DaviVolcan/STM32H743IIT6-Core-Board/README.md

# STM32H743IIT6 Core Board V1.3

Community documentation for the STM32H743IIT6 Core Board V1.3, produced by a Chinese manufacturer.

> **Note:** The original manufacturer schematics are not included in this repository because it has not been possible
> to get in contact with the manufacturer. A community re-capture of the V1.3 schematic in KiCad is available in
> [hardware/kicad](hardware/kicad/STM32H743_CoreBoard), with a
> [PDF render](hardware/kicad/STM32H743_CoreBoard/STM32H743_CoreBoard_render.pdf).
> **Note:** We are not fully sure about the exact manufacturer company name yet.

---

## Overview

| Item | Details |
|---|---|
| MCU | STM32H743IIT6 (LQFP176) |
| Core | ARM Cortex-M7 @ up to 480 MHz |
| Flash | 2 MB internal + 16 MB external QSPI |
| RAM | 1 MB internal + 32MB external SDRAM |
| Board revision | V1.3 |
| Schematic date | Unknown |

---

## Board Pictures

### Top View
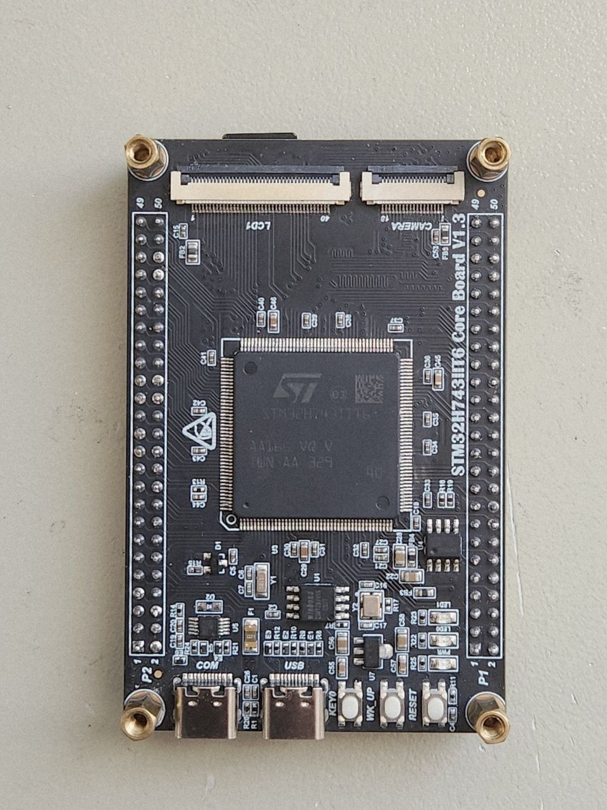
[picture p1: assets/top.jpg]
STM32H743IIT6 Core Board - Top View


> **Note:** One diode is missing on this top-side photo.

### Bottom View
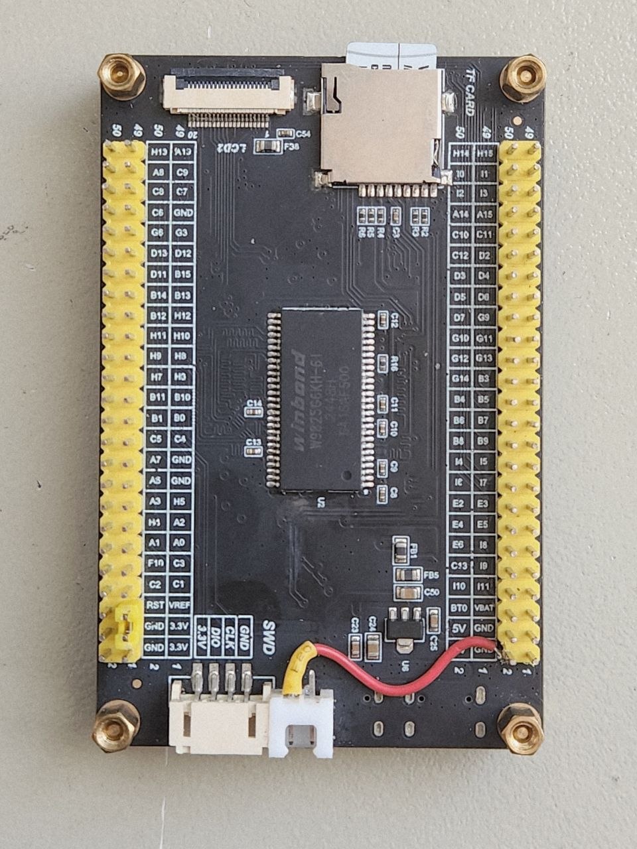
[picture p2: assets/bottom.jpg]
STM32H743IIT6 Core Board - Bottom View


> **Note:** This bottom-side photo shows a user-applied mod.

### Component Close-ups

Close-up photos used to identify the on-board parts are shown in
[Peripheral Details](docs/peripherals.md):

- [QSPI flash, HSE crystal, LDO and EEPROM](assets/closeup-qspi-hse-ldo.jpg) — see
  [Clocks](docs/peripherals.md#clocks), [QSPI Flash](docs/peripherals.md#qspi-flash) and
  [Power](docs/peripherals.md#power)
- [SDRAM and header silkscreen](assets/closeup-sdram-headers.jpg) — see
  [SDRAM](docs/peripherals.md#sdram)
- [EEPROM (U4)](assets/eeprom.jpg) — see [EEPROM](docs/peripherals.md#eeprom)
- [USB-UART bridge, LSE crystal and USB area](assets/closeup-usb-uart-lse.jpg) — see
  [COM Ports](docs/peripherals.md#com-ports) and [USB](docs/peripherals.md#usb)

---

## Quick Links

- [Pin Assignments](docs/pinout.md)
- [Peripheral Details](docs/peripherals.md)
- [KiCad Schematic](hardware/kicad/STM32H743_CoreBoard) ([PDF](hardware/kicad/STM32H743_CoreBoard/STM32H743_CoreBoard_render.pdf))

---

## Contributing

If you have additional details about this board (measured pin functions, tested peripheral configs, confirmed part
numbers), please open an issue or PR.
