DaviVolcan/STM32H743IIT6-Core-Board/hardware/kicad/STM32H743_CoreBoard/STM32H743_CoreBoard_render.pdf

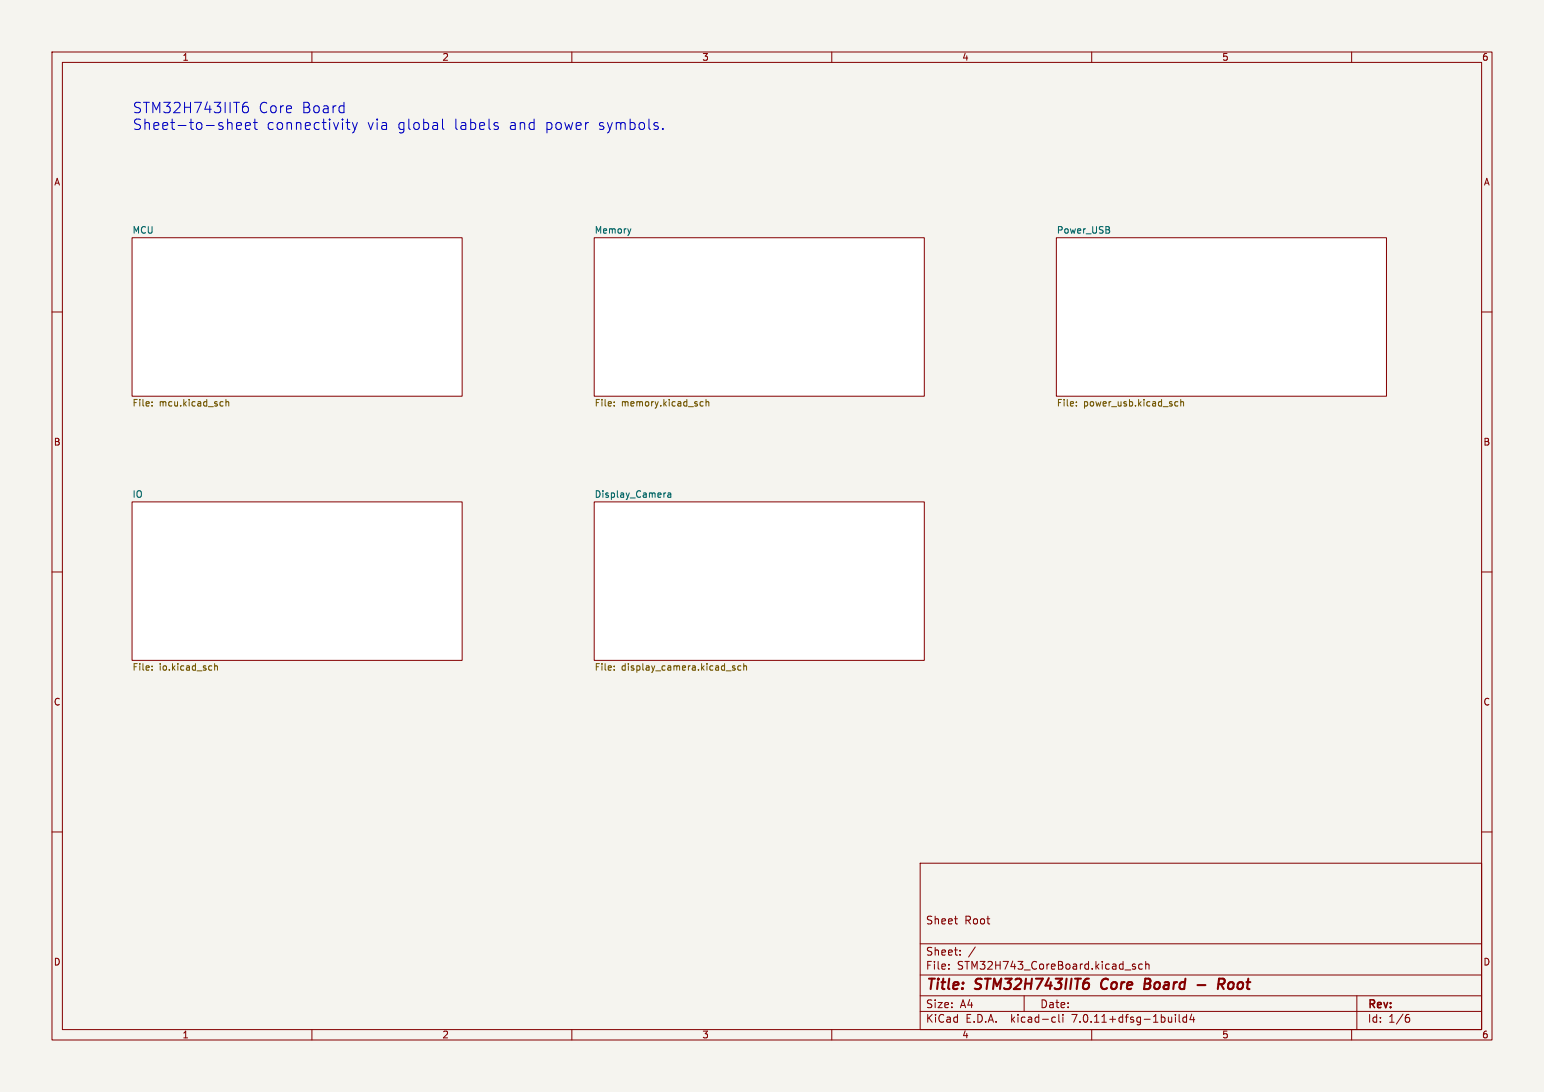
[picture p7: page 1]

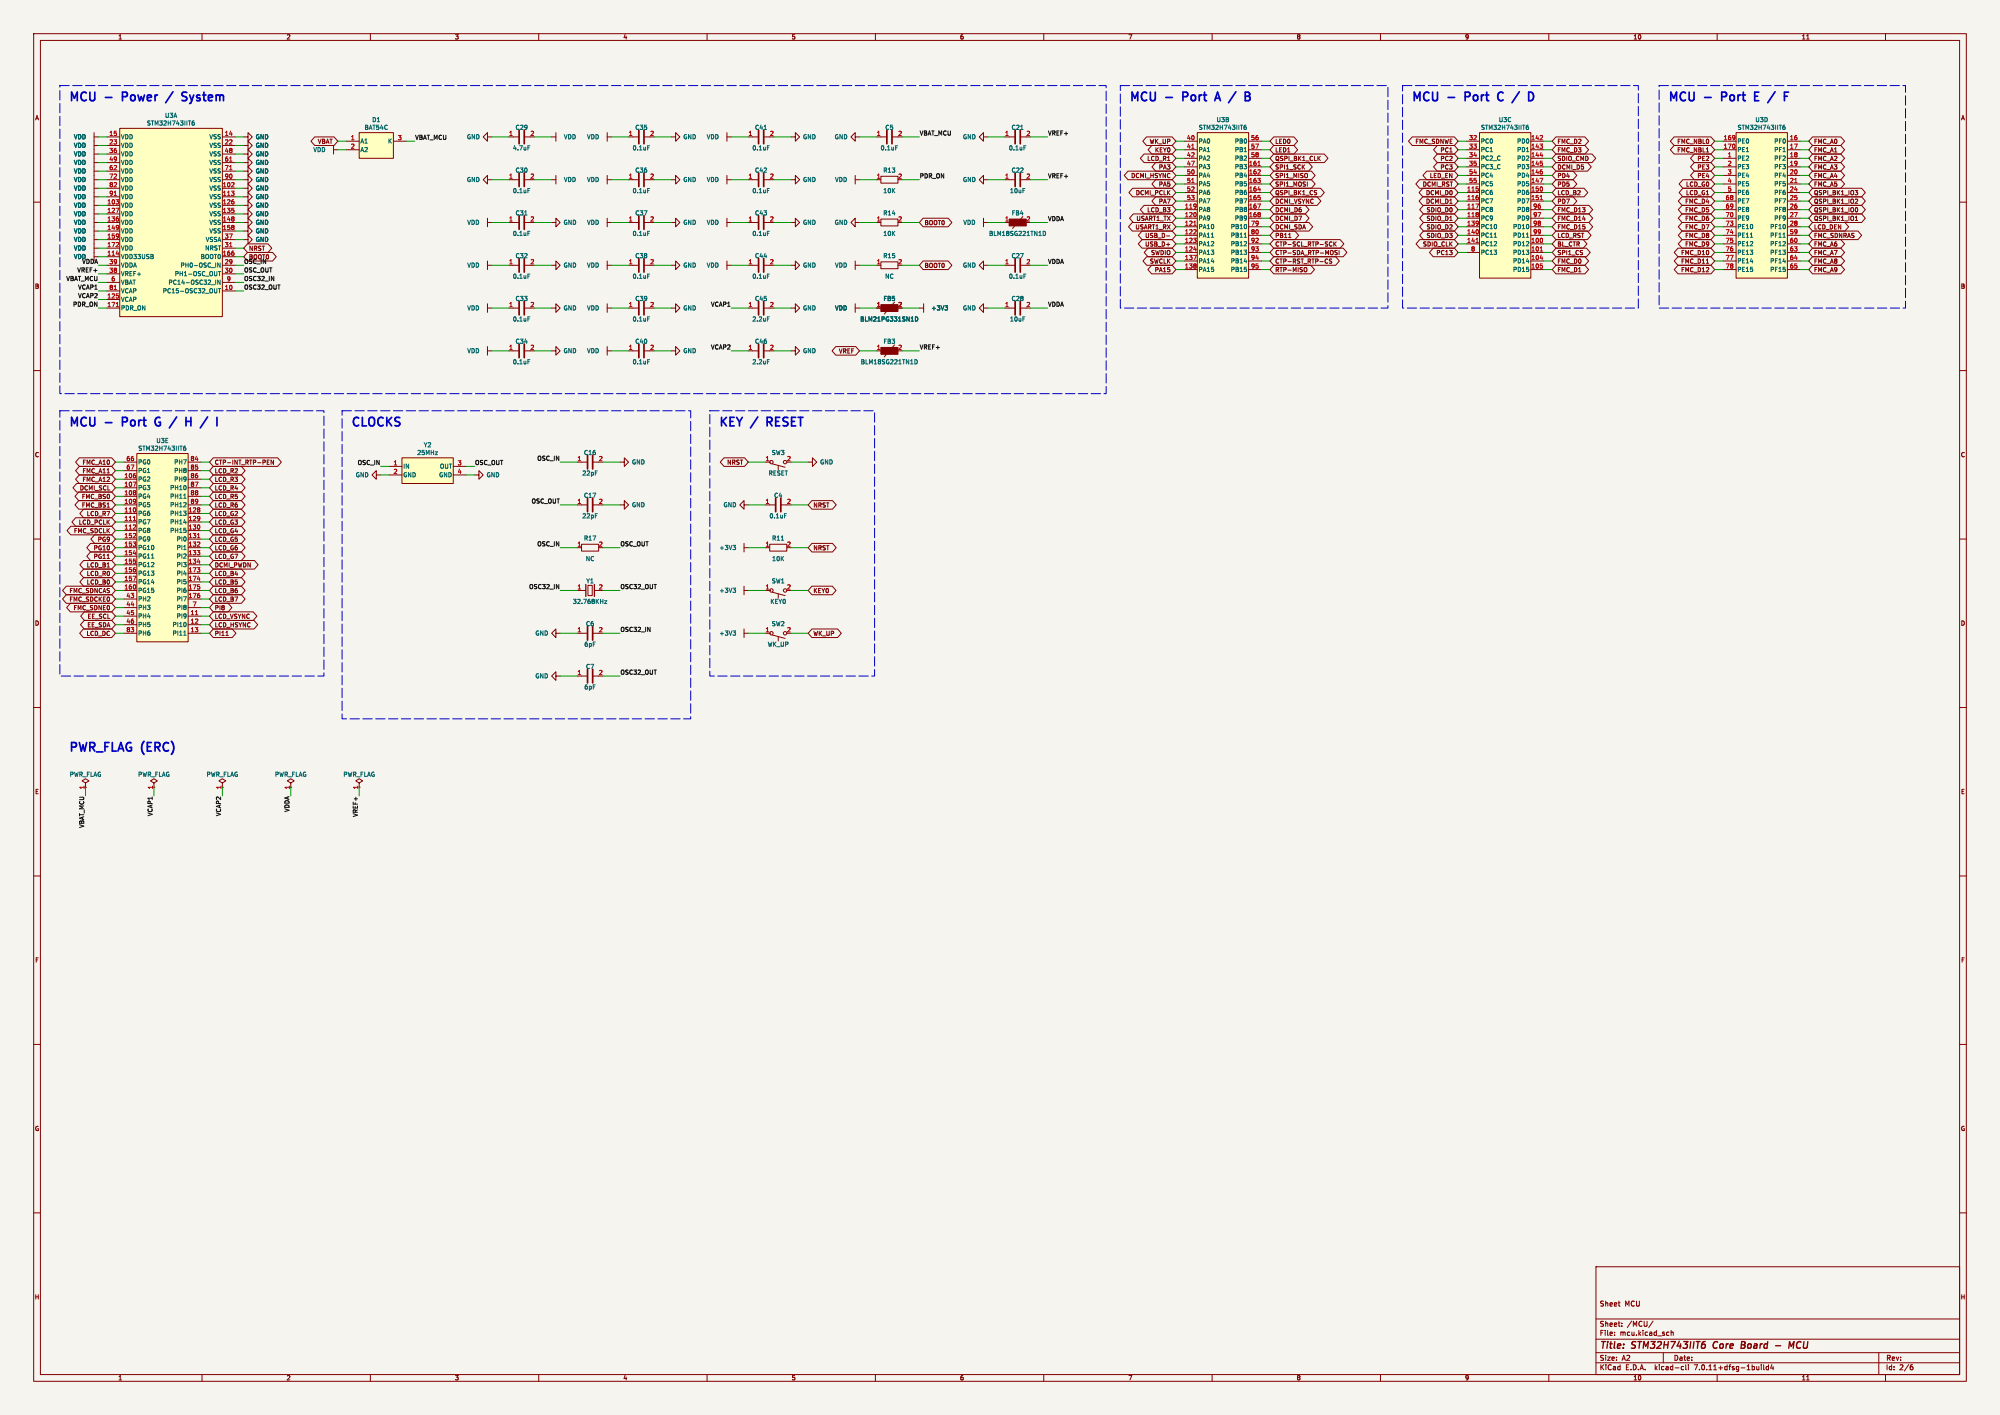
[picture p8: page 2]

PB11 CTP-SCL_RTP-SCK CTP-SDA_RTP-MOSI CTP-RST_RTP-CS RTP-MISO

File: mcu.kicad_sch Sheet: /MCU/ Sheet MCU

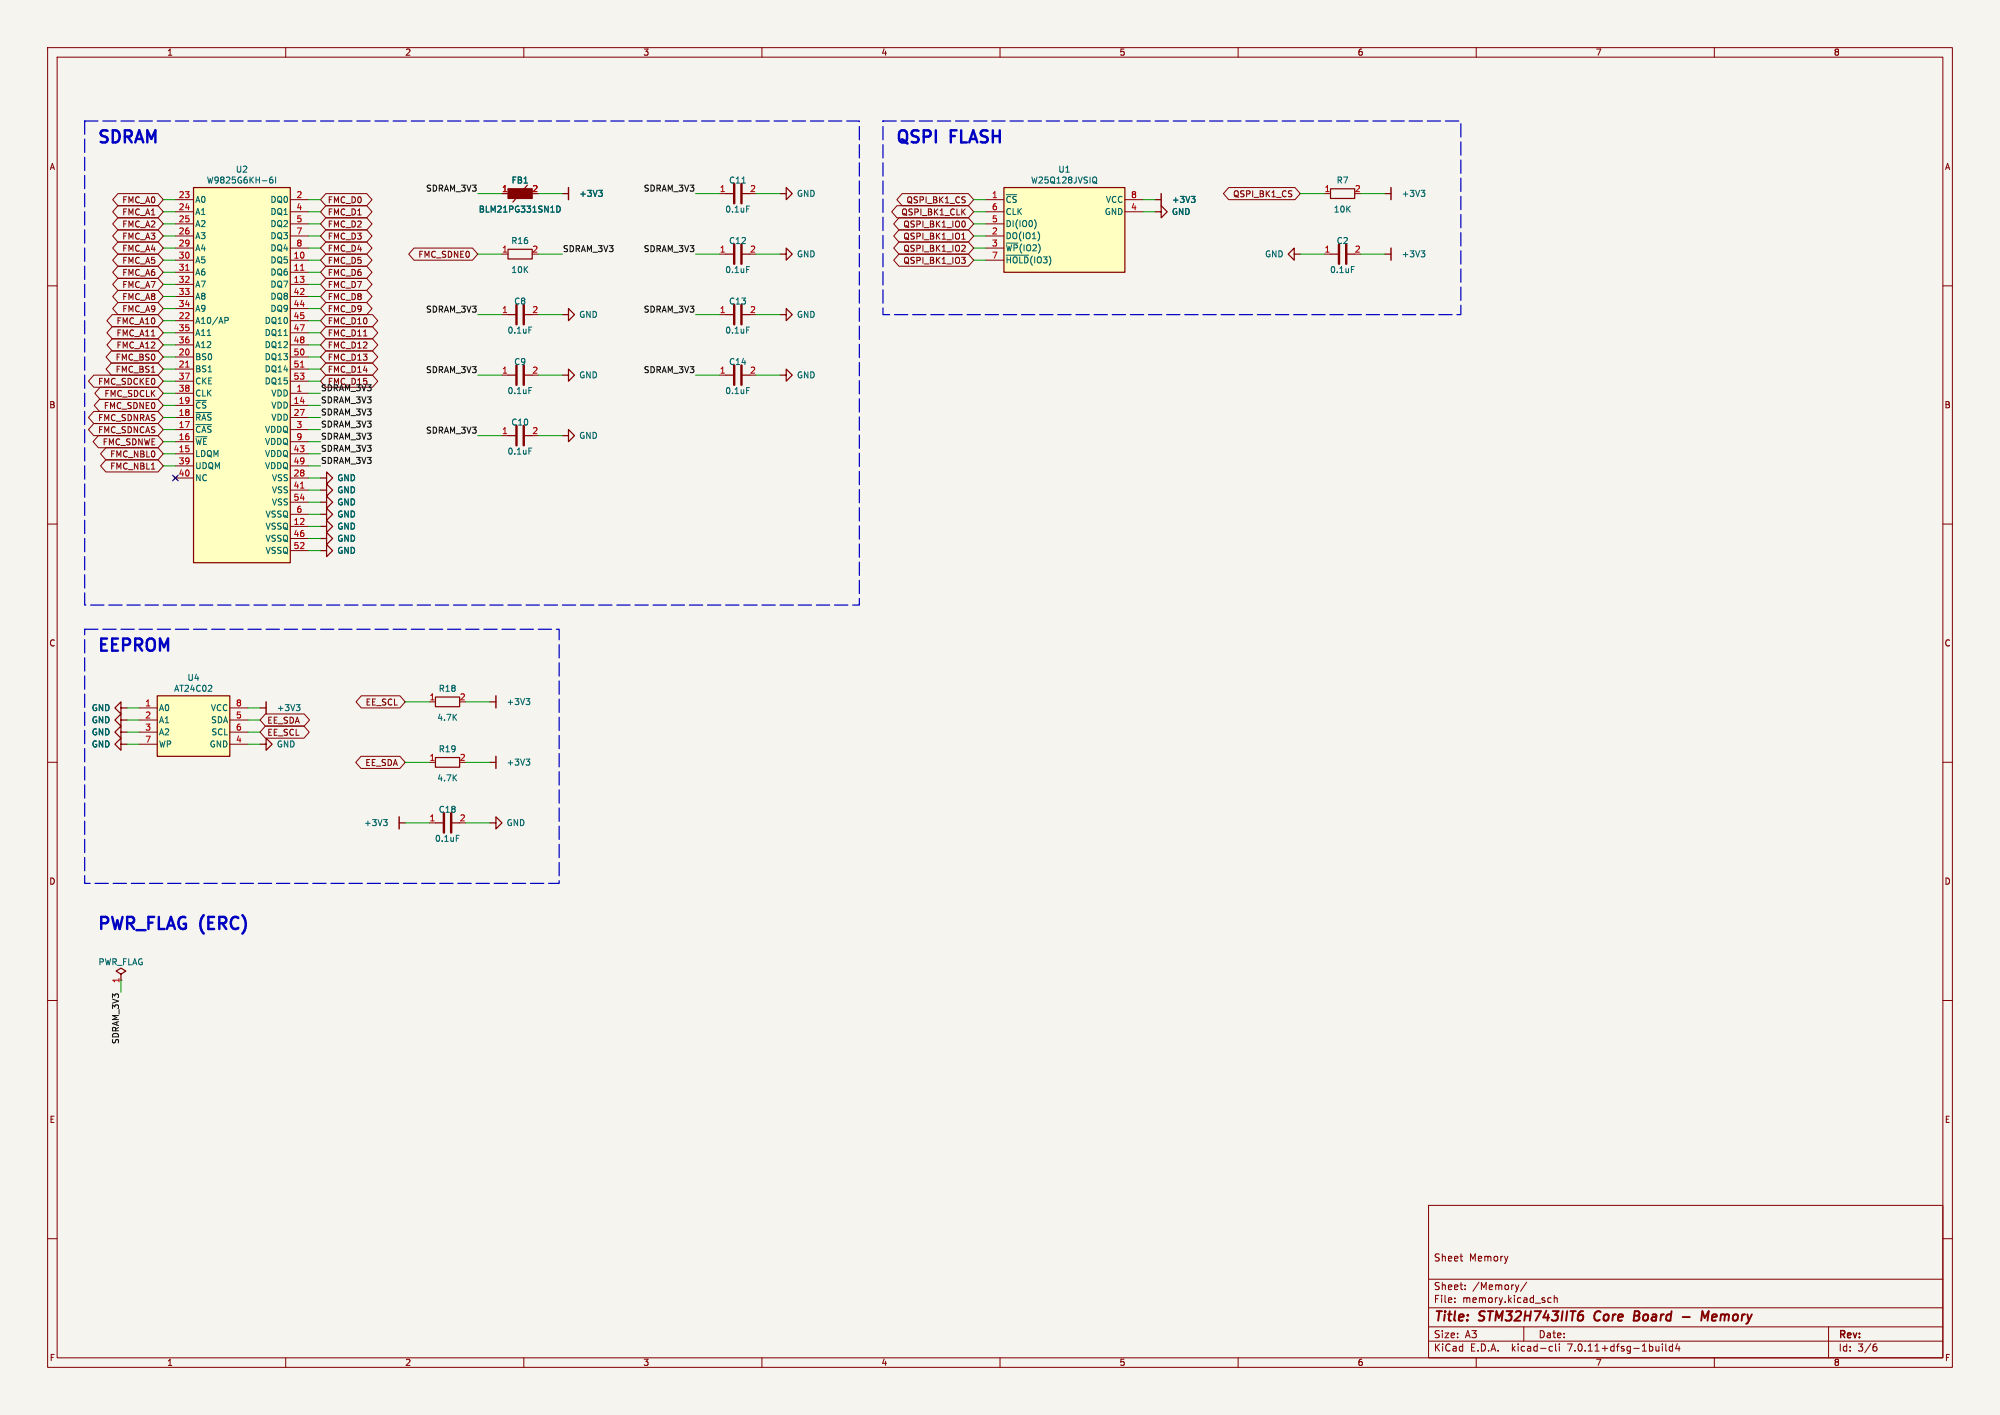
[picture p9: page 3]

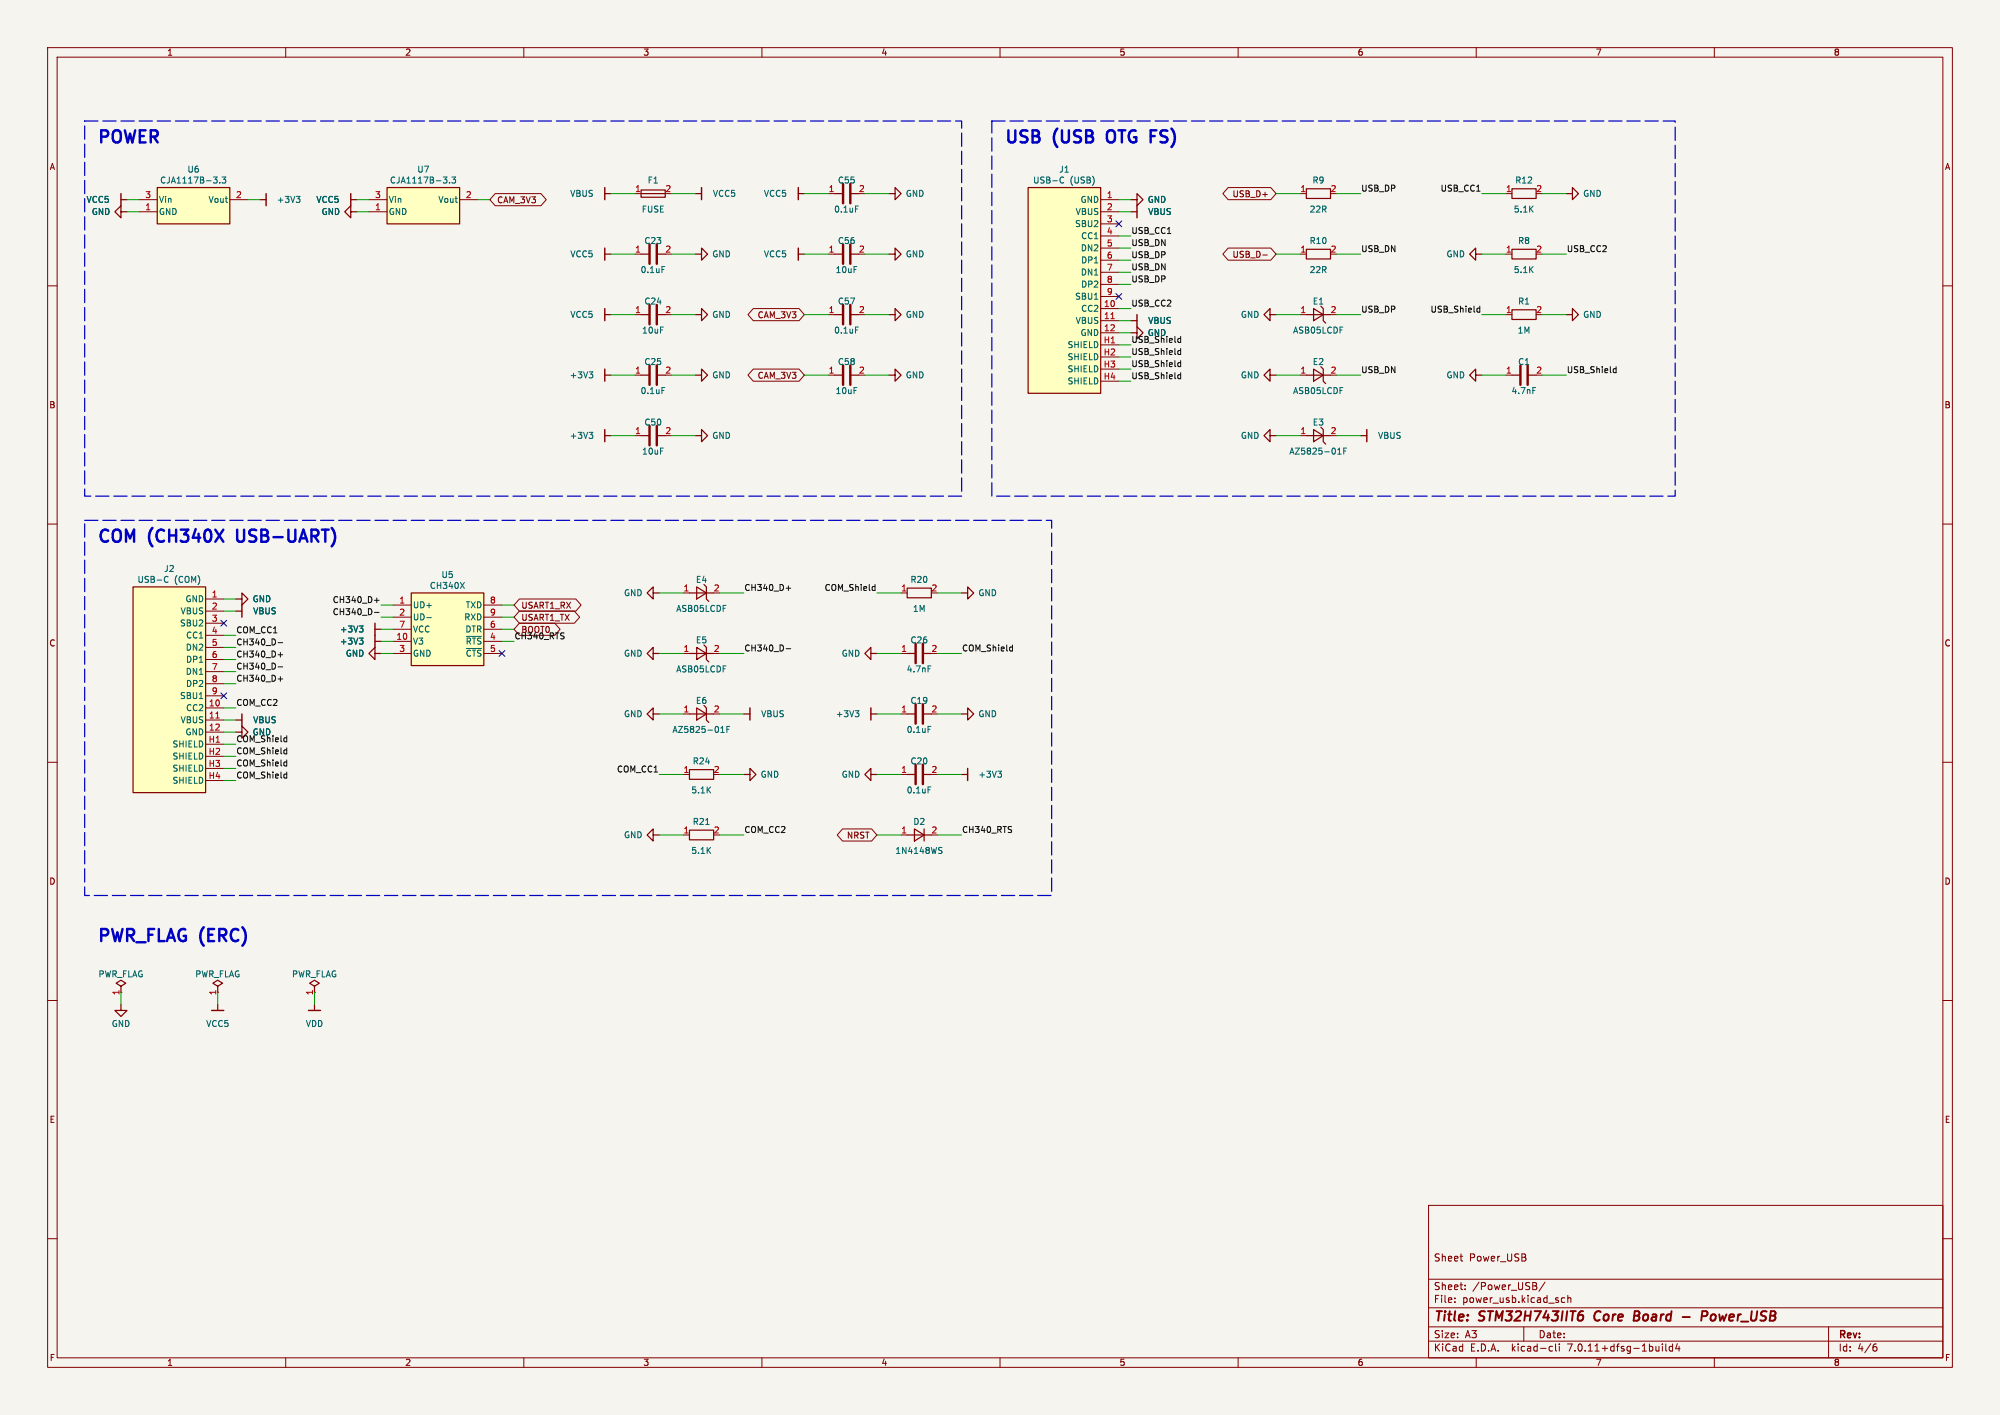
[picture p10: page 4]

COM (CH340X USB-UART) VBUS GND

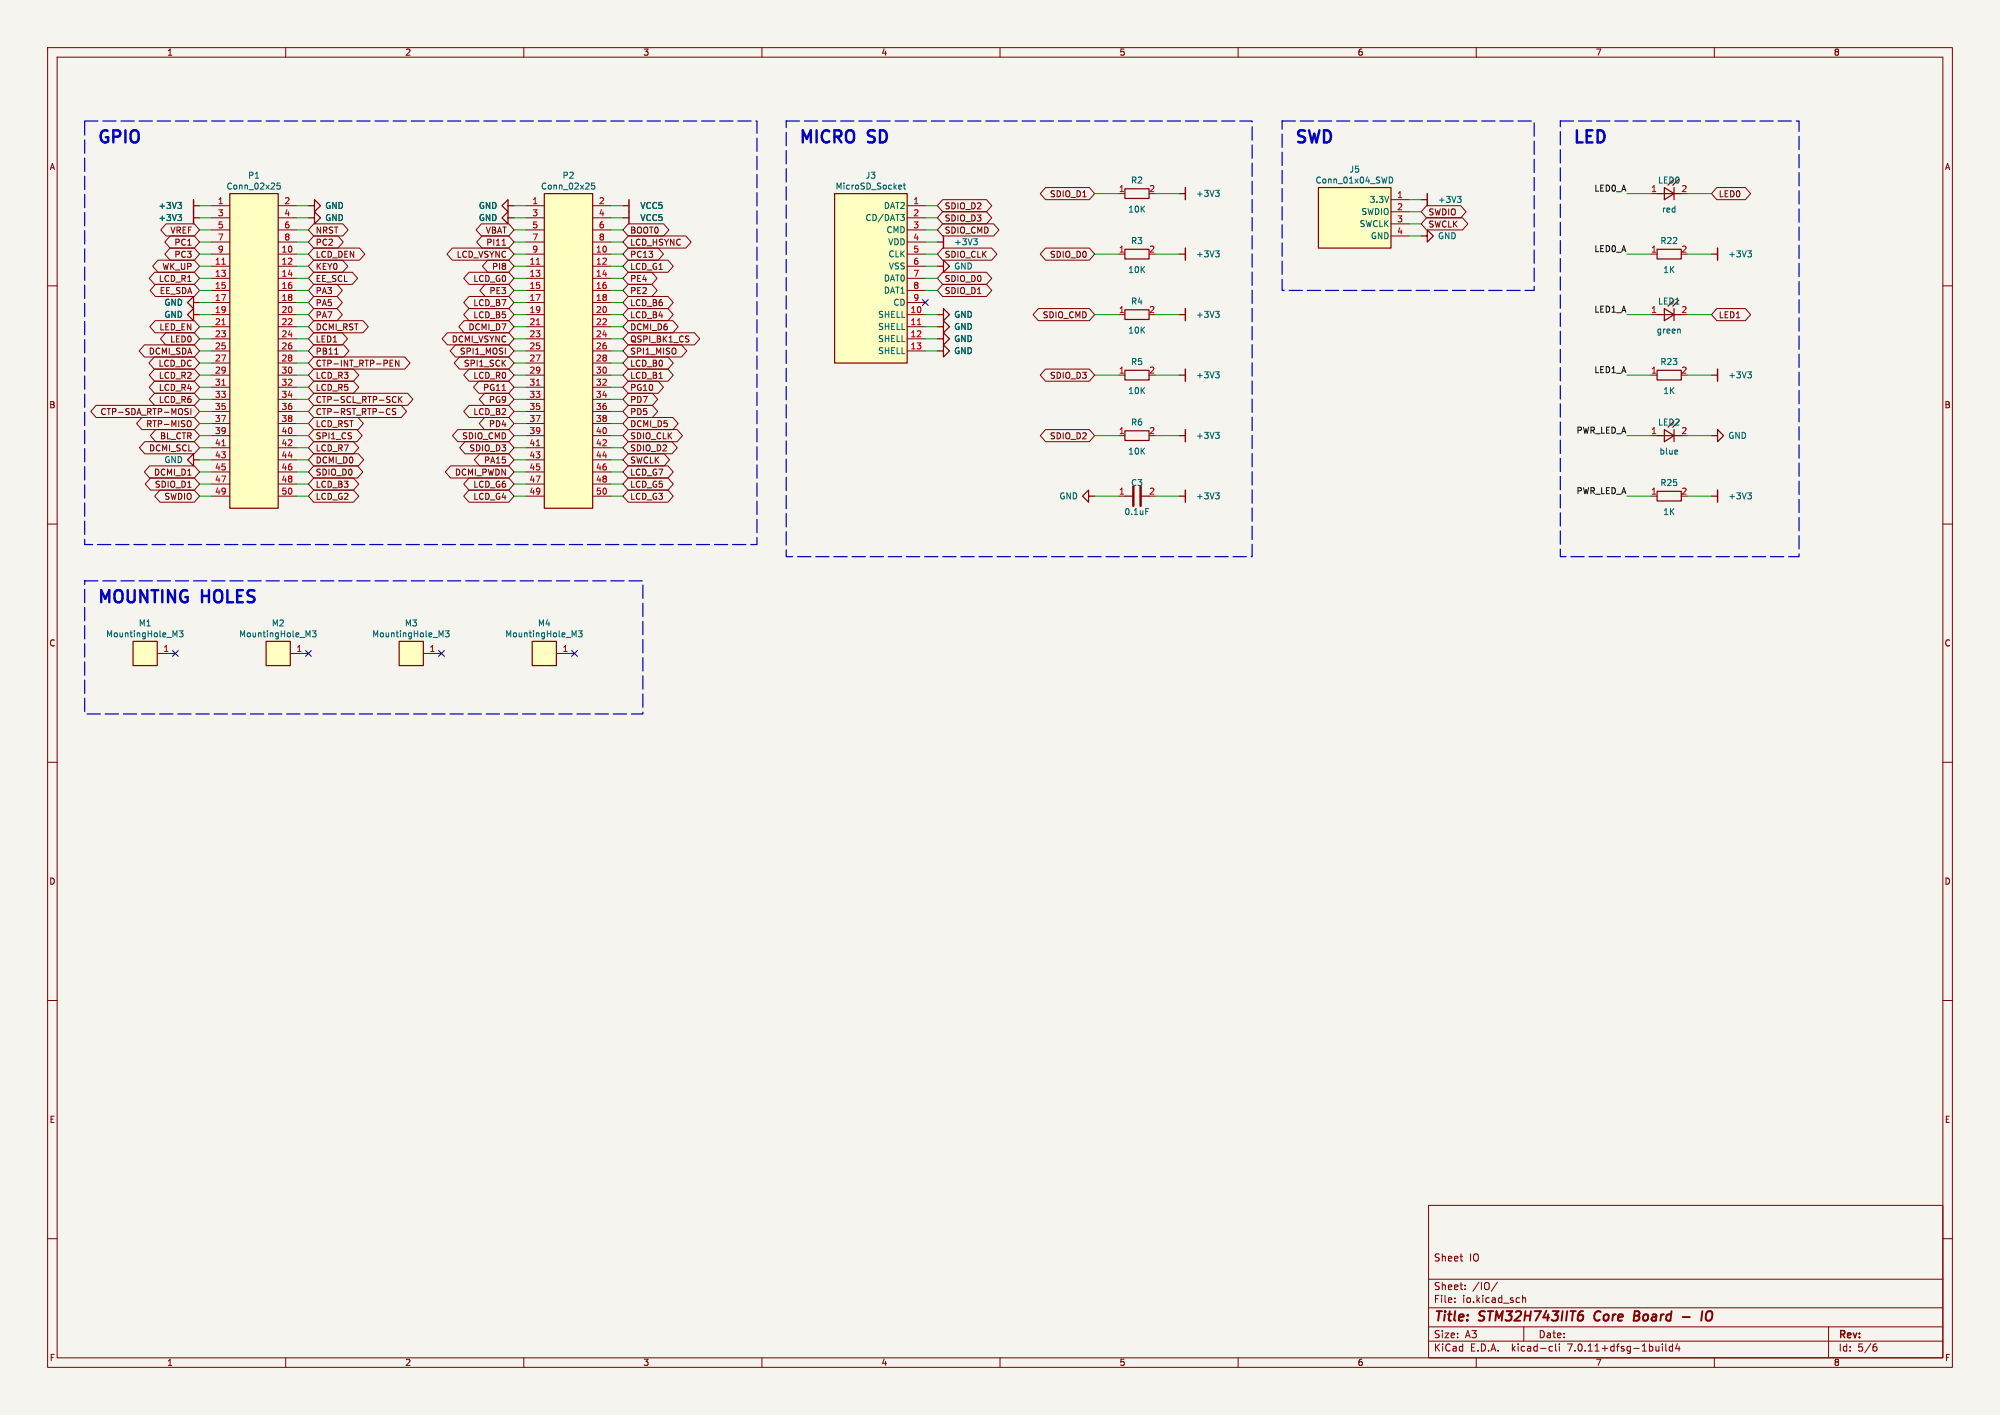
[picture p11: page 5]

green GND GND GND GND

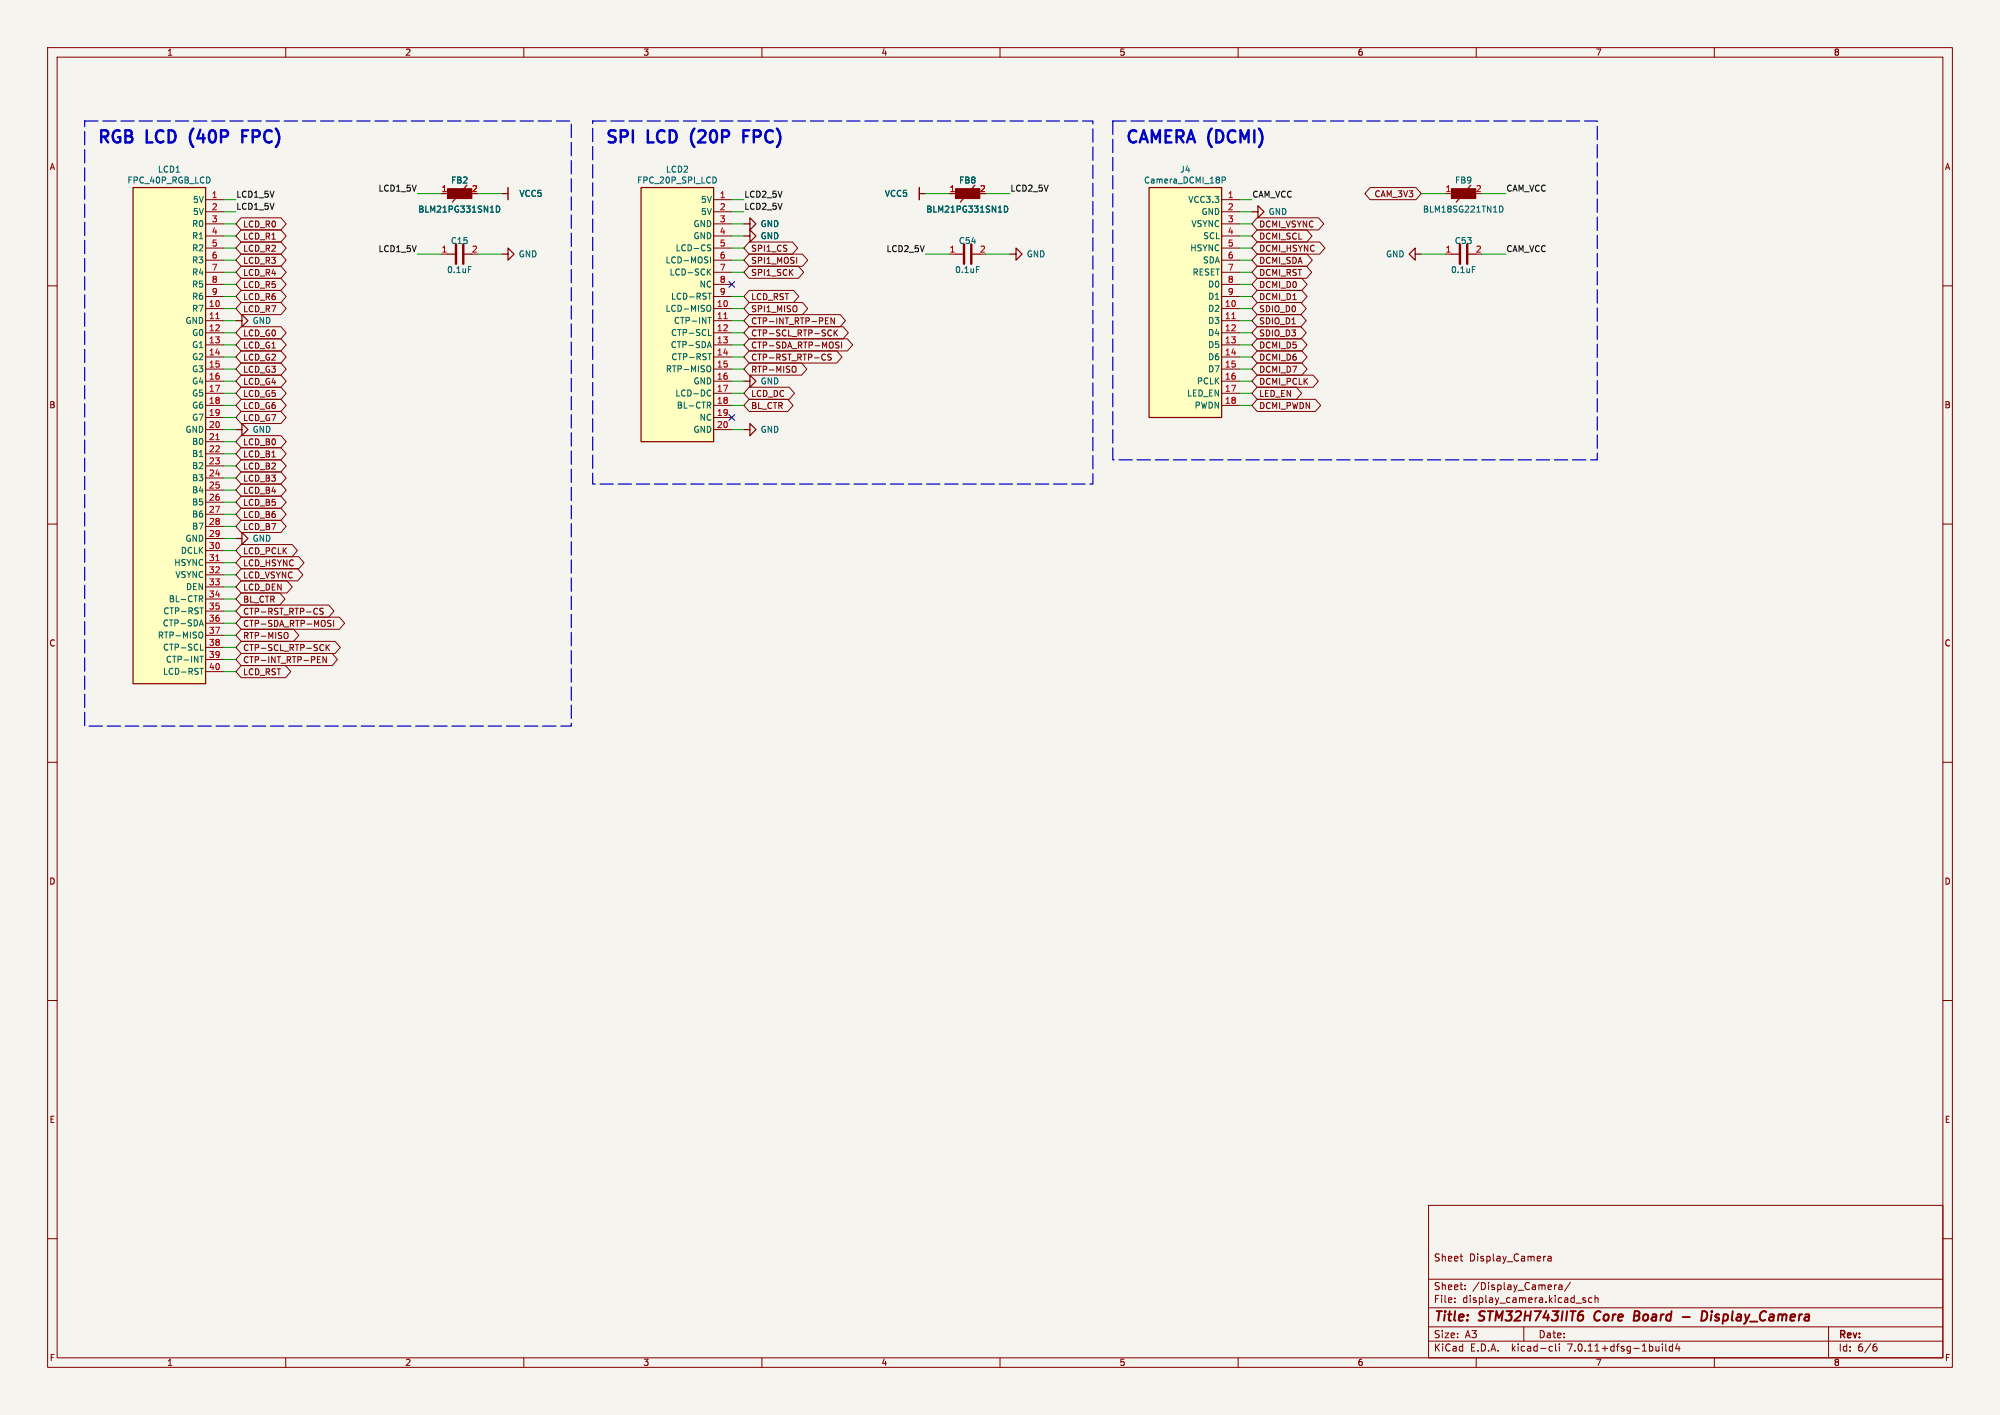
[picture p12: page 6]

LED_EN 17 PWDN 18 GND 2 VSYNC 3 SCL 4 HSYNC 5 SDA 6 RESET 7 D0 8 D1 9

CTP-INT_RTP-PEN
CTP-SCL_RTP-SCK CTP-SDA_RTP-MOSI CTP-RST_RTP-CS RTP-MISO
