DaviVolcan/STM32H743IIT6-Core-Board/hardware/kicad/STM32H743_CoreBoard/display_camera.kicad_sch

## KiCad design hardware/kicad/STM32H743_CoreBoard/display_camera.kicad_sch (2026-11-04)

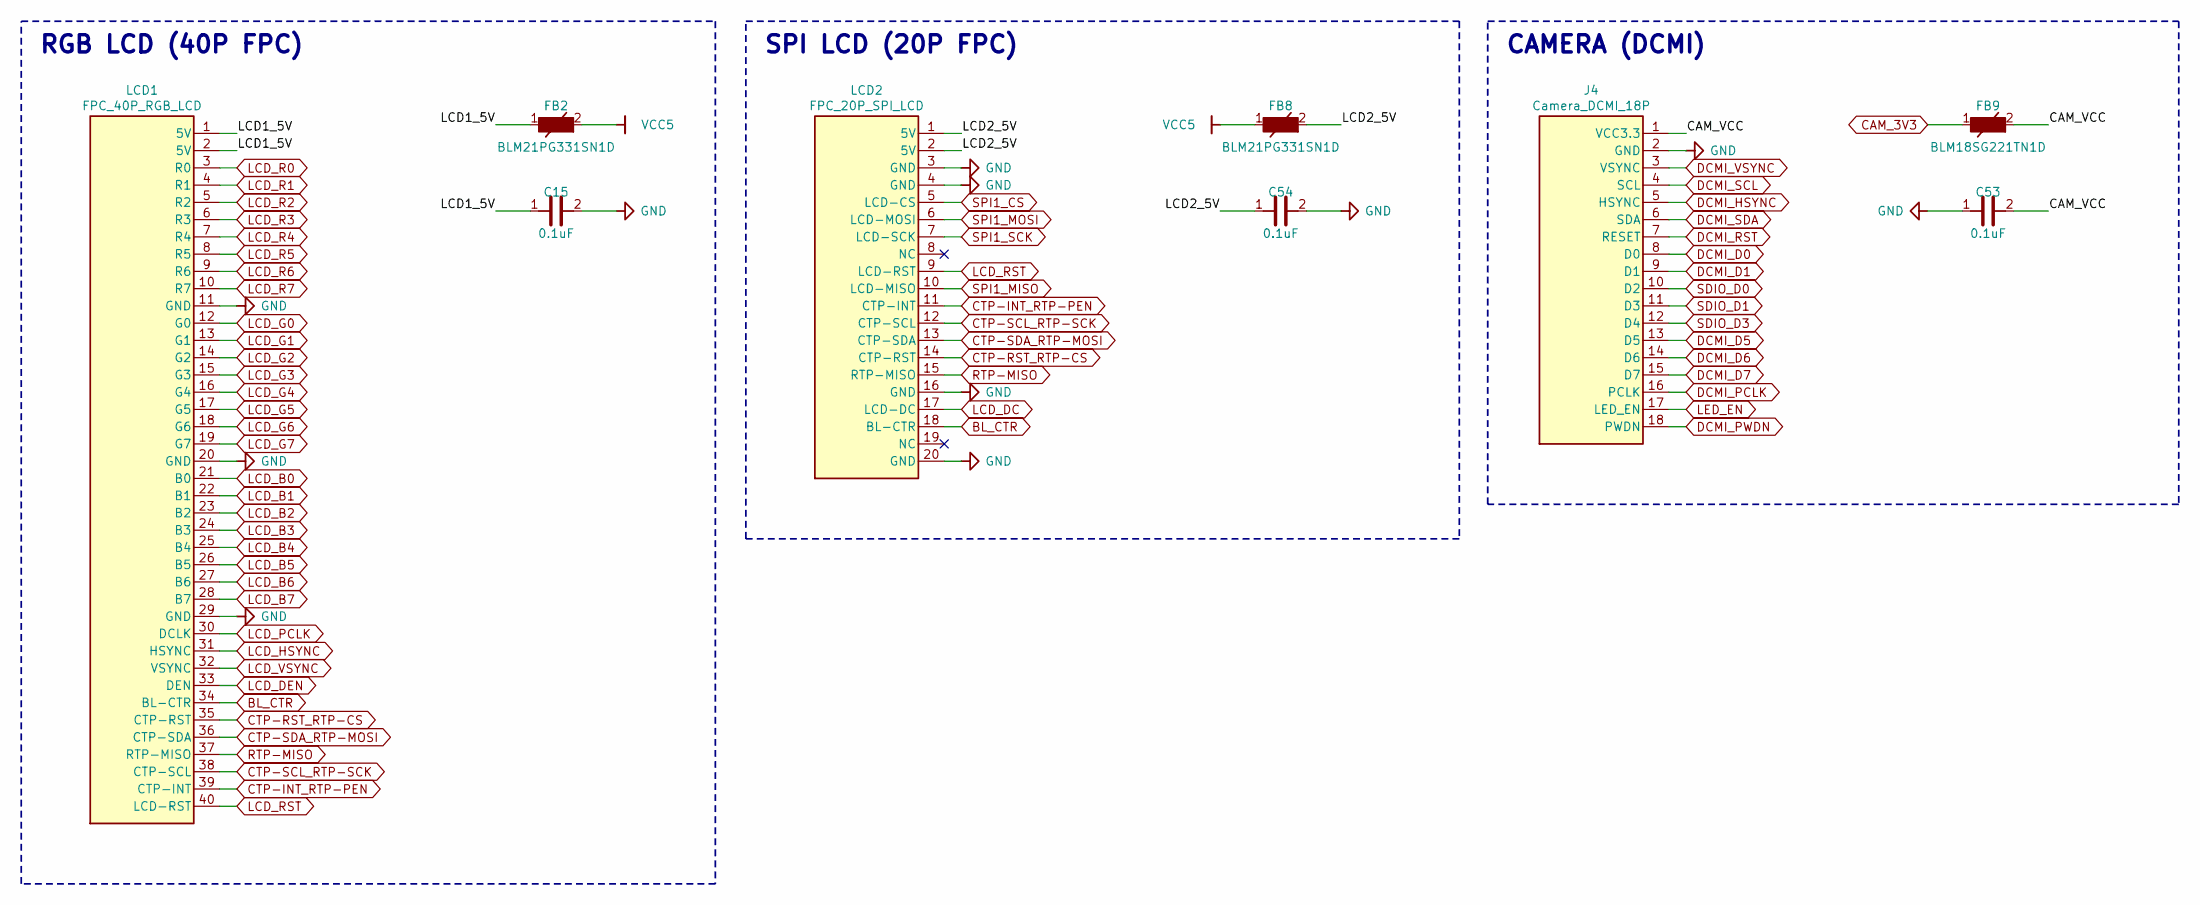
[picture p13: schematic display_camera.kicad_sch]

Parts:
C15, C53, C54: 0.1uF; C_0603_1608Metric
FB2, FB8: BLM21PG331SN1D; L_0805_2012Metric
FB9: BLM18SG221TN1D; L_0603_1608Metric
J4: Camera_DCMI_18P
LCD1: FPC_40P_RGB_LCD
LCD2: FPC_20P_SPI_LCD

Connections:
BL_CTR: LCD1.34 (BL-CTR), LCD2.18 (BL-CTR)
CAM_3V3: FB9.1
CAM_VCC: C53.2, FB9.2, J4.1 (VCC3.3)
CTP-INT_RTP-PEN: LCD1.39 (CTP-INT), LCD2.11 (CTP-INT)
CTP-RST_RTP-CS: LCD1.35 (CTP-RST), LCD2.14 (CTP-RST)
CTP-SCL_RTP-SCK: LCD1.38 (CTP-SCL), LCD2.12 (CTP-SCL)
CTP-SDA_RTP-MOSI: LCD1.36 (CTP-SDA), LCD2.13 (CTP-SDA)
DCMI_D0: J4.8 (D0)
DCMI_D1: J4.9 (D1)
DCMI_D5: J4.13 (D5)
DCMI_D6: J4.14 (D6)
DCMI_D7: J4.15 (D7)
DCMI_HSYNC: J4.5 (HSYNC)
DCMI_PCLK: J4.16 (PCLK)
DCMI_PWDN: J4.18 (PWDN)
DCMI_RST: J4.7 (RESET)
DCMI_SCL: J4.4 (SCL)
DCMI_SDA: J4.6 (SDA)
DCMI_VSYNC: J4.3 (VSYNC)
GND: C15.2, C53.1, C54.2, J4.2 (GND), LCD1.11 (GND), LCD1.20 (GND), LCD1.29 (GND), LCD2.3 (GND), LCD2.4 (GND), LCD2.16 (GND), LCD2.20 (GND)
LCD1_5V: C15.1, FB2.1, LCD1.1 (5V), LCD1.2 (5V)
LCD2_5V: C54.1, FB8.2, LCD2.1 (5V), LCD2.2 (5V)
LCD_B0: LCD1.21 (B0)
LCD_B1: LCD1.22 (B1)
LCD_B2: LCD1.23 (B2)
LCD_B3: LCD1.24 (B3)
LCD_B4: LCD1.25 (B4)
LCD_B5: LCD1.26 (B5)
LCD_B6: LCD1.27 (B6)
LCD_B7: LCD1.28 (B7)
LCD_DC: LCD2.17 (LCD-DC)
LCD_DEN: LCD1.33 (DEN)
LCD_G0: LCD1.12 (G0)
LCD_G1: LCD1.13 (G1)
LCD_G2: LCD1.14 (G2)
LCD_G3: LCD1.15 (G3)
LCD_G4: LCD1.16 (G4)
LCD_G5: LCD1.17 (G5)
LCD_G6: LCD1.18 (G6)
LCD_G7: LCD1.19 (G7)
LCD_HSYNC: LCD1.31 (HSYNC)
LCD_PCLK: LCD1.30 (DCLK)
LCD_R0: LCD1.3 (R0)
LCD_R1: LCD1.4 (R1)
LCD_R2: LCD1.5 (R2)
LCD_R3: LCD1.6 (R3)
LCD_R4: LCD1.7 (R4)
LCD_R5: LCD1.8 (R5)
LCD_R6: LCD1.9 (R6)
LCD_R7: LCD1.10 (R7)
LCD_RST: LCD1.40 (LCD-RST), LCD2.9 (LCD-RST)
LCD_VSYNC: LCD1.32 (VSYNC)
LED_EN: J4.17 (LED_EN)
RTP-MISO: LCD1.37 (RTP-MISO), LCD2.15 (RTP-MISO)
SDIO_D0: J4.10 (D2)
SDIO_D1: J4.11 (D3)
SDIO_D3: J4.12 (D4)
SPI1_CS: LCD2.5 (LCD-CS)
SPI1_MISO: LCD2.10 (LCD-MISO)
SPI1_MOSI: LCD2.6 (LCD-MOSI)
SPI1_SCK: LCD2.7 (LCD-SCK)
VCC5: FB2.2, FB8.1

Notes on the sheet:
RGB LCD (40P FPC)
SPI LCD (20P FPC)
CAMERA (DCMI)
