DaviVolcan/STM32H743IIT6-Core-Board/hardware/kicad/STM32H743_CoreBoard/io.kicad_sch

## KiCad design hardware/kicad/STM32H743_CoreBoard/io.kicad_sch (2026-11-04)

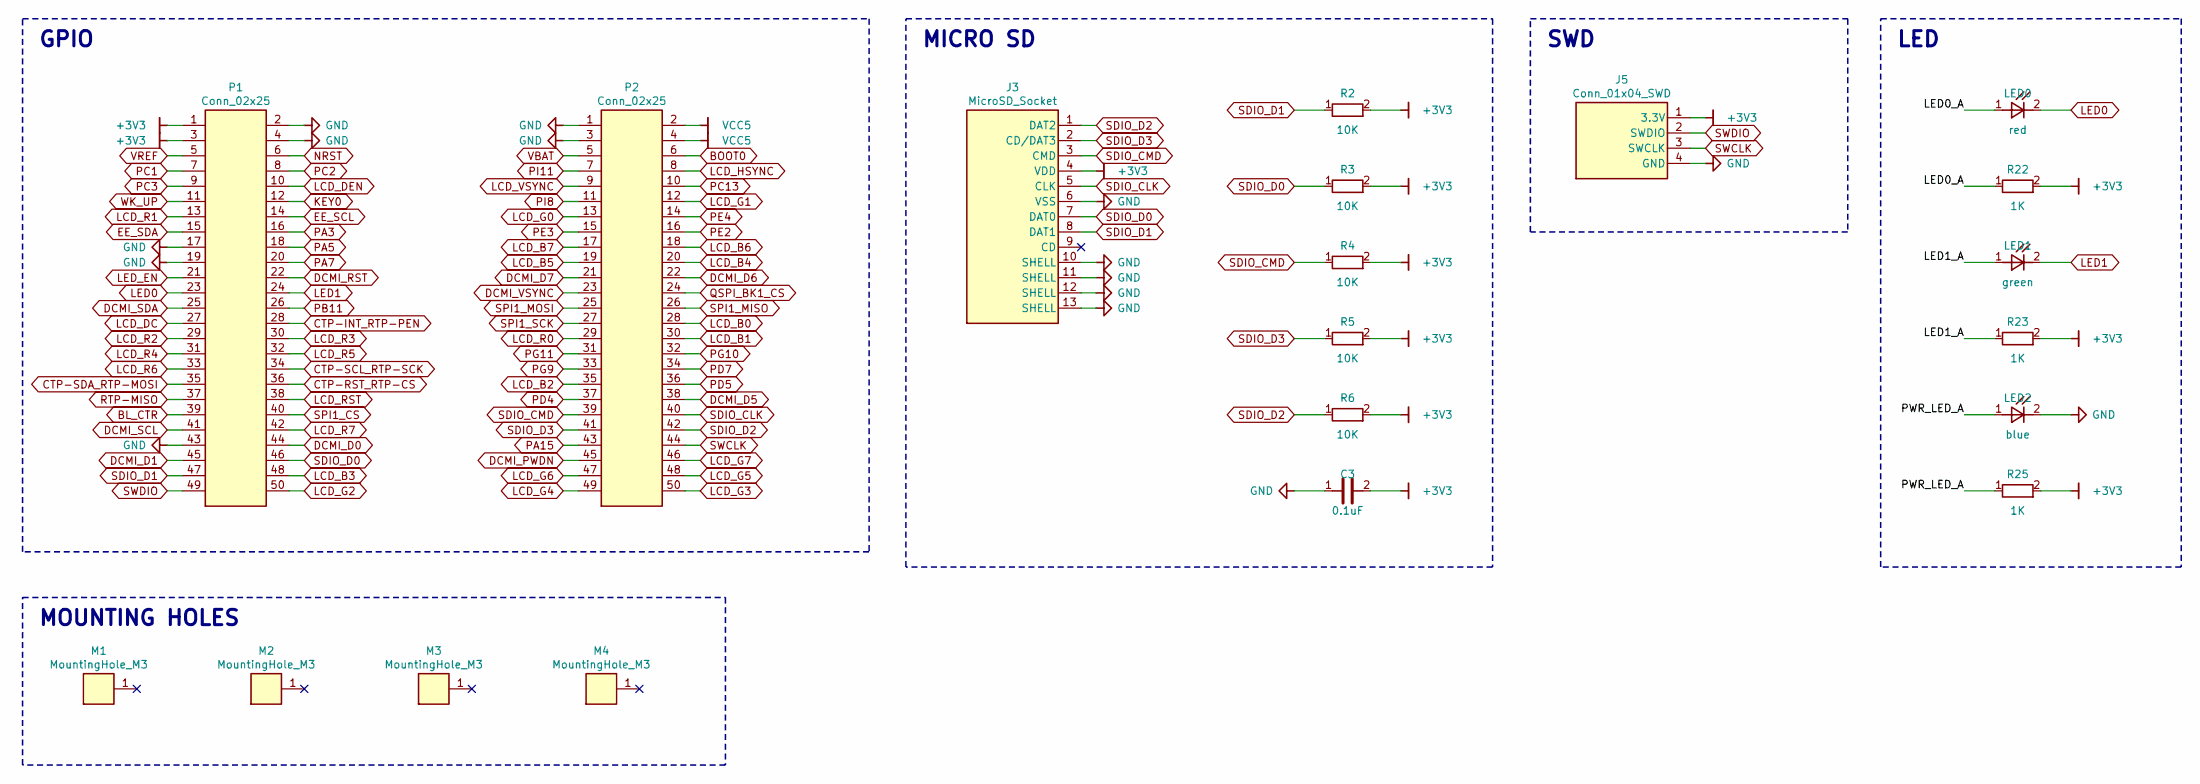
[picture p14: schematic io.kicad_sch]

Parts:
C3: 0.1uF; C_0603_1608Metric
J3: MicroSD_Socket
J5: Conn_01x04_SWD; PinHeader_1x04_P2.54mm_Vertical
LED0: red; LED_0603_1608Metric
LED1: green; LED_0603_1608Metric
LED2: blue; LED_0603_1608Metric
M1, M2, M3, M4: MountingHole_M3; MountingHole_3.2mm_M3_Pad
P1, P2: Conn_02x25; PinHeader_2x25_P2.54mm_Vertical
R2, R3, R4, R5, R6: 10K; R_0603_1608Metric
R22, R23, R25: 1K; R_0603_1608Metric

Connections:
+3V3: C3.2, J3.4 (VDD), J5.1 (3.3V), P1.1, P1.3, R2.2, R3.2, R4.2, R5.2, R6.2, R22.2, R23.2, R25.2
BL_CTR: P1.39
BOOT0: P2.6
CTP-INT_RTP-PEN: P1.28
CTP-RST_RTP-CS: P1.36
CTP-SCL_RTP-SCK: P1.34
CTP-SDA_RTP-MOSI: P1.35
DCMI_D0: P1.44
DCMI_D1: P1.45
DCMI_D5: P2.38
DCMI_D6: P2.22
DCMI_D7: P2.21
DCMI_PWDN: P2.45
DCMI_RST: P1.22
DCMI_SCL: P1.41
DCMI_SDA: P1.25
DCMI_VSYNC: P2.23
EE_SCL: P1.14
EE_SDA: P1.15
GND: C3.1, J3.6 (VSS), J3.10 (SHELL), J3.11 (SHELL), J3.12 (SHELL), J3.13 (SHELL), J5.4 (GND), LED2.2, P1.2, P1.4, P1.17, P1.19, P1.43, P2.1, P2.3
KEY0: P1.12
LCD_B0: P2.28
LCD_B1: P2.30
LCD_B2: P2.35
LCD_B3: P1.48
LCD_B4: P2.20
LCD_B5: P2.19
LCD_B6: P2.18
LCD_B7: P2.17
LCD_DC: P1.27
LCD_DEN: P1.10
LCD_G0: P2.13
LCD_G1: P2.12
LCD_G2: P1.50
LCD_G3: P2.50
LCD_G4: P2.49
LCD_G5: P2.48
LCD_G6: P2.47
LCD_G7: P2.46
LCD_HSYNC: P2.8
LCD_R0: P2.29
LCD_R1: P1.13
LCD_R2: P1.29
LCD_R3: P1.30
LCD_R4: P1.31
LCD_R5: P1.32
LCD_R6: P1.33
LCD_R7: P1.42
LCD_RST: P1.38
LCD_VSYNC: P2.9
LED0: LED0.2, P1.23
LED0_A: LED0.1, R22.1
LED1: LED1.2, P1.24
LED1_A: LED1.1, R23.1
LED_EN: P1.21
NRST: P1.6
PA3: P1.16
PA5: P1.18
PA7: P1.20
PA15: P2.43
PB11: P1.26
PC1: P1.7
PC2: P1.8
PC3: P1.9
PC13: P2.10
PD4: P2.37
PD5: P2.36
PD7: P2.34
PE2: P2.16
PE3: P2.15
PE4: P2.14
PG9: P2.33
PG10: P2.32
PG11: P2.31
PI8: P2.11
PI11: P2.7
PWR_LED_A: LED2.1, R25.1
QSPI_BK1_CS: P2.24
RTP-MISO: P1.37
SDIO_CLK: J3.5 (CLK), P2.40
SDIO_CMD: J3.3 (CMD), P2.39, R4.1
SDIO_D0: J3.7 (DAT0), P1.46, R3.1
SDIO_D1: J3.8 (DAT1), P1.47, R2.1
SDIO_D2: J3.1 (DAT2), P2.42, R6.1
SDIO_D3: J3.2 (CD/DAT3), P2.41, R5.1
SPI1_CS: P1.40
SPI1_MISO: P2.26
SPI1_MOSI: P2.25
SPI1_SCK: P2.27
SWCLK: J5.3 (SWCLK), P2.44
SWDIO: J5.2 (SWDIO), P1.49
VBAT: P2.5
VCC5: P2.2, P2.4
VREF: P1.5
WK_UP: P1.11

Notes on the sheet:
GPIO
MICRO SD
SWD
LED
MOUNTING HOLES
