DaviVolcan/STM32H743IIT6-Core-Board/hardware/kicad/STM32H743_CoreBoard/mcu.kicad_sch

## KiCad design hardware/kicad/STM32H743_CoreBoard/mcu.kicad_sch (2026-11-04)

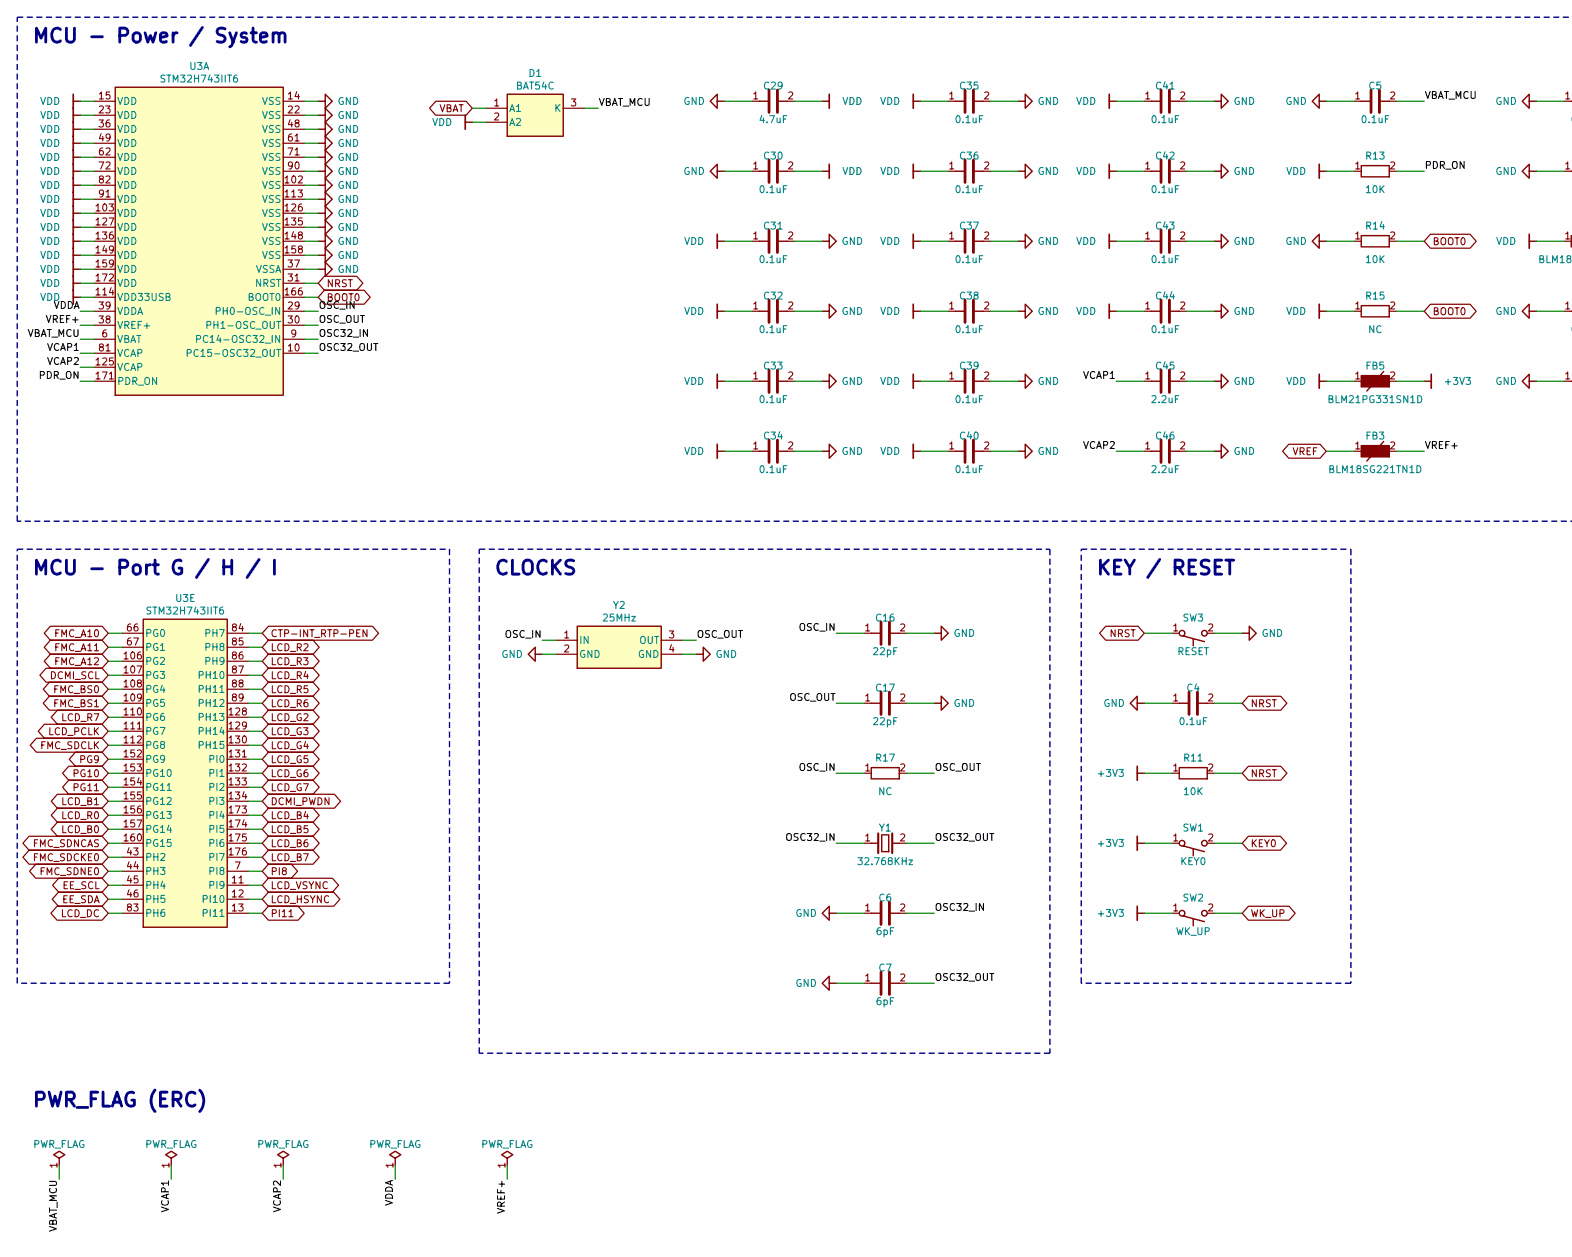
[picture p15: schematic mcu.kicad_sch, part in row 1, column 1]

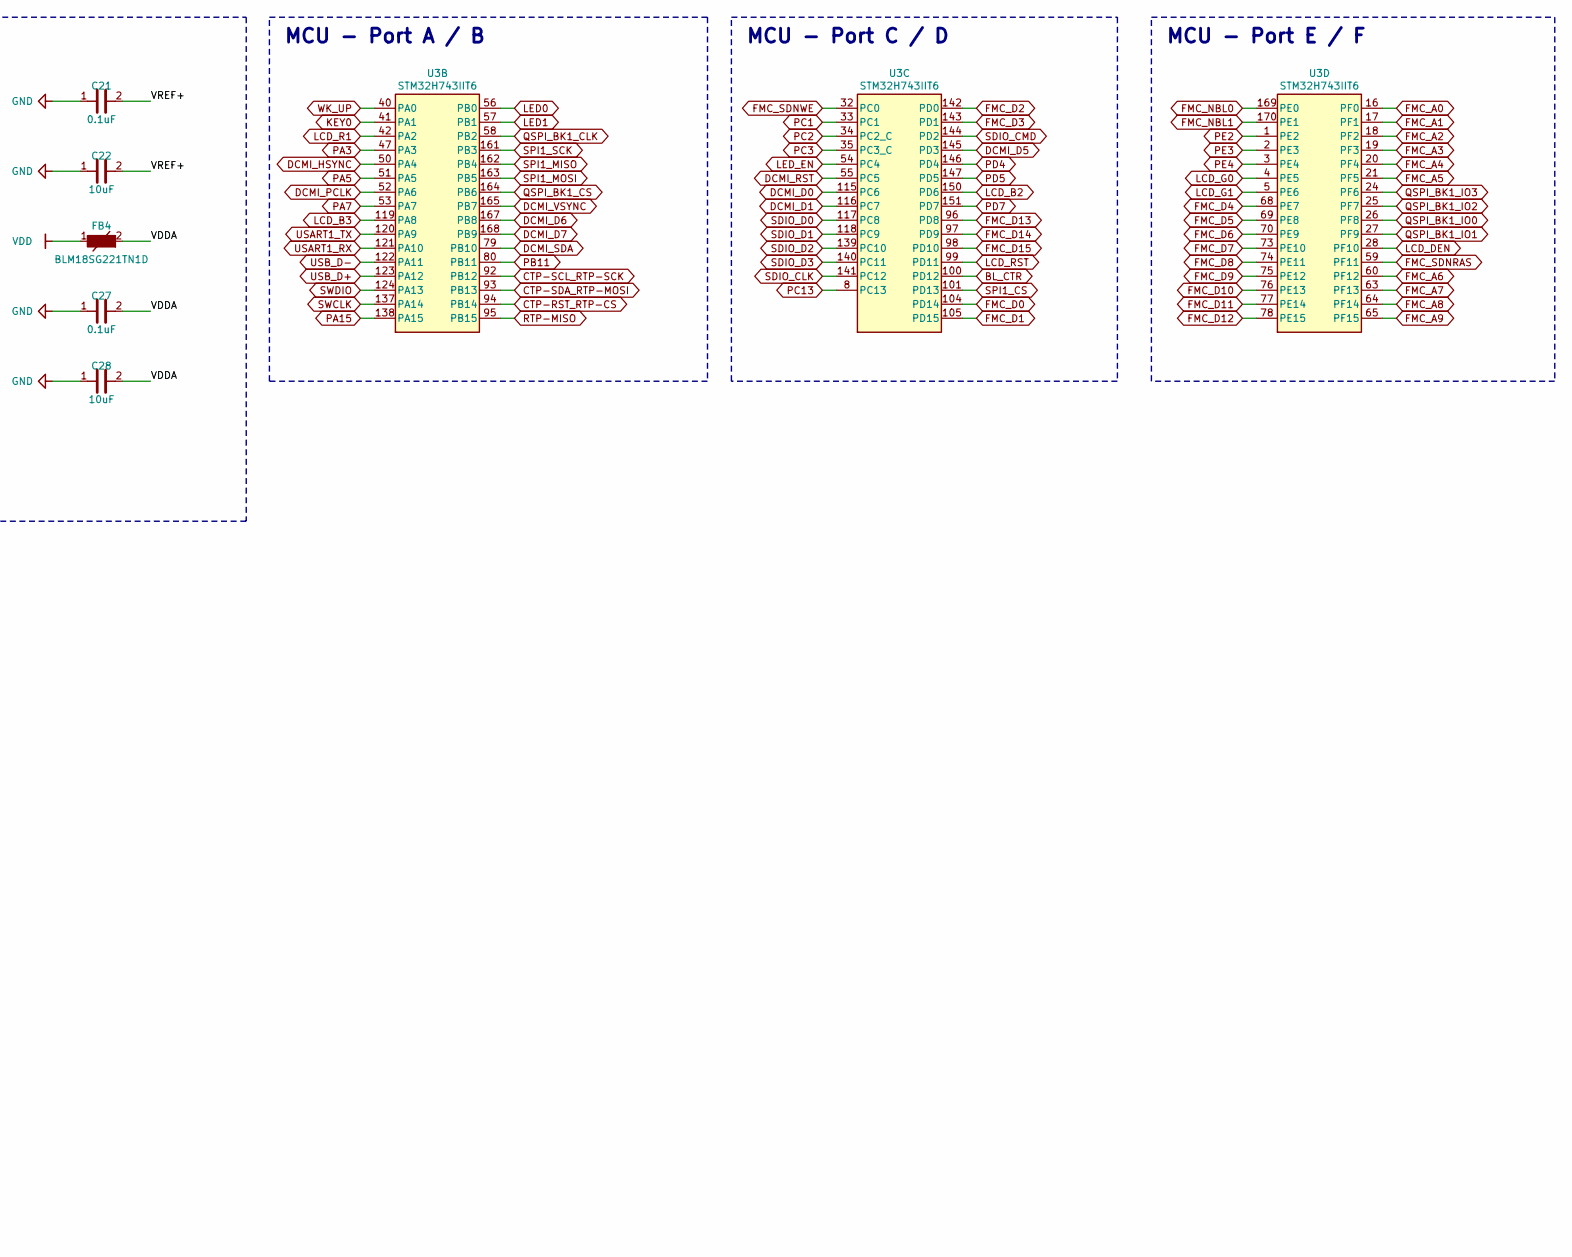
[picture p16: schematic mcu.kicad_sch, part in row 1, column 2]

Parts:
C4, C5, C21, C27, C30, C31, C32, C33, C34, C35, C36, C37, C38, C39, C40, C41, C42, C43, C44: 0.1uF; C_0603_1608Metric
C6, C7: 6pF; C_0603_1608Metric
C16, C17: 22pF; C_0603_1608Metric
C22, C28: 10uF; C_0805_2012Metric
C29: 4.7uF; C_0805_2012Metric
C45, C46: 2.2uF; C_0603_1608Metric
D1: BAT54C; SOT-23
FB3, FB4: BLM18SG221TN1D; L_0603_1608Metric
FB5: BLM21PG331SN1D; L_0805_2012Metric
R11, R13, R14: 10K; R_0603_1608Metric
R15, R17: NC; R_0603_1608Metric
SW1: KEY0
SW2: WK_UP
SW3: RESET
U3: STM32H743IIT6; LQFP-176_24x24mm_P0.5mm
Y1: 32.768KHz; Crystal_SMD_3215-2Pin_3.2x1.5mm
Y2: 25MHz; Crystal_SMD_3225-4Pin_3.2x2.5mm

Connections:
+3V3: FB5.2, R11.1, SW1.1, SW2.1
BL_CTR: U3.100 (PD12)
BOOT0: R14.2, R15.2, U3.166 (BOOT0)
CTP-INT_RTP-PEN: U3.84 (PH7)
CTP-RST_RTP-CS: U3.94 (PB14)
CTP-SCL_RTP-SCK: U3.92 (PB12)
CTP-SDA_RTP-MOSI: U3.93 (PB13)
DCMI_D0: U3.115 (PC6)
DCMI_D1: U3.116 (PC7)
DCMI_D5: U3.145 (PD3)
DCMI_D6: U3.167 (PB8)
DCMI_D7: U3.168 (PB9)
DCMI_HSYNC: U3.50 (PA4)
DCMI_PCLK: U3.52 (PA6)
DCMI_PWDN: U3.134 (PI3)
DCMI_RST: U3.55 (PC5)
DCMI_SCL: U3.107 (PG3)
DCMI_SDA: U3.79 (PB10)
DCMI_VSYNC: U3.165 (PB7)
EE_SCL: U3.45 (PH4)
EE_SDA: U3.46 (PH5)
FMC_A0: U3.16 (PF0)
FMC_A1: U3.17 (PF1)
FMC_A2: U3.18 (PF2)
FMC_A3: U3.19 (PF3)
FMC_A4: U3.20 (PF4)
FMC_A5: U3.21 (PF5)
FMC_A6: U3.60 (PF12)
FMC_A7: U3.63 (PF13)
FMC_A8: U3.64 (PF14)
FMC_A9: U3.65 (PF15)
FMC_A10: U3.66 (PG0)
FMC_A11: U3.67 (PG1)
FMC_A12: U3.106 (PG2)
FMC_BS0: U3.108 (PG4)
FMC_BS1: U3.109 (PG5)
FMC_D0: U3.104 (PD14)
FMC_D1: U3.105 (PD15)
FMC_D2: U3.142 (PD0)
FMC_D3: U3.143 (PD1)
FMC_D4: U3.68 (PE7)
FMC_D5: U3.69 (PE8)
FMC_D6: U3.70 (PE9)
FMC_D7: U3.73 (PE10)
FMC_D8: U3.74 (PE11)
FMC_D9: U3.75 (PE12)
FMC_D10: U3.76 (PE13)
FMC_D11: U3.77 (PE14)
FMC_D12: U3.78 (PE15)
FMC_D13: U3.96 (PD8)
FMC_D14: U3.97 (PD9)
FMC_D15: U3.98 (PD10)
FMC_NBL0: U3.169 (PE0)
FMC_NBL1: U3.170 (PE1)
FMC_SDCKE0: U3.43 (PH2)
FMC_SDCLK: U3.112 (PG8)
FMC_SDNCAS: U3.160 (PG15)
FMC_SDNE0: U3.44 (PH3)
FMC_SDNRAS: U3.59 (PF11)
FMC_SDNWE: U3.32 (PC0)
GND: C4.1, C5.1, C6.1, C7.1, C16.2, C17.2, C21.1, C22.1, C27.1, C28.1, C29.1, C30.1, C31.2, C32.2, C33.2, C34.2, C35.2, C36.2, C37.2, C38.2, C39.2, C40.2, C41.2, C42.2, C43.2, C44.2, C45.2, C46.2, R14.1, SW3.2, U3.14 (VSS), U3.22 (VSS), U3.37 (VSSA), U3.48 (VSS), U3.61 (VSS), U3.71 (VSS), U3.90 (VSS), U3.102 (VSS), U3.113 (VSS), U3.126 (VSS), U3.135 (VSS), U3.148 (VSS), U3.158 (VSS), Y2.2 (GND), Y2.4 (GND)
KEY0: SW1.2, U3.41 (PA1)
LCD_B0: U3.157 (PG14)
LCD_B1: U3.155 (PG12)
LCD_B2: U3.150 (PD6)
LCD_B3: U3.119 (PA8)
LCD_B4: U3.173 (PI4)
LCD_B5: U3.174 (PI5)
LCD_B6: U3.175 (PI6)
LCD_B7: U3.176 (PI7)
LCD_DC: U3.83 (PH6)
LCD_DEN: U3.28 (PF10)
LCD_G0: U3.4 (PE5)
LCD_G1: U3.5 (PE6)
LCD_G2: U3.128 (PH13)
LCD_G3: U3.129 (PH14)
LCD_G4: U3.130 (PH15)
LCD_G5: U3.131 (PI0)
LCD_G6: U3.132 (PI1)
LCD_G7: U3.133 (PI2)
LCD_HSYNC: U3.12 (PI10)
LCD_PCLK: U3.111 (PG7)
LCD_R0: U3.156 (PG13)
LCD_R1: U3.42 (PA2)
LCD_R2: U3.85 (PH8)
LCD_R3: U3.86 (PH9)
LCD_R4: U3.87 (PH10)
LCD_R5: U3.88 (PH11)
LCD_R6: U3.89 (PH12)
LCD_R7: U3.110 (PG6)
LCD_RST: U3.99 (PD11)
LCD_VSYNC: U3.11 (PI9)
LED0: U3.56 (PB0)
LED1: U3.57 (PB1)
LED_EN: U3.54 (PC4)
NRST: C4.2, R11.2, SW3.1, U3.31 (NRST)
OSC32_IN: C6.2, U3.9 (PC14-OSC32_IN), Y1.1
OSC32_OUT: C7.2, U3.10 (PC15-OSC32_OUT), Y1.2
OSC_IN: C16.1, R17.1, U3.29 (PH0-OSC_IN), Y2.1 (IN)
OSC_OUT: C17.1, R17.2, U3.30 (PH1-OSC_OUT), Y2.3 (OUT)
PA3: U3.47 (PA3)
PA5: U3.51 (PA5)
PA7: U3.53 (PA7)
PA15: U3.138 (PA15)
PB11: U3.80 (PB11)
PC1: U3.33 (PC1)
PC2: U3.34 (PC2_C)
PC3: U3.35 (PC3_C)
PC13: U3.8 (PC13)
PD4: U3.146 (PD4)
PD5: U3.147 (PD5)
PD7: U3.151 (PD7)
PDR_ON: R13.2, U3.171 (PDR_ON)
PE2: U3.1 (PE2)
PE3: U3.2 (PE3)
PE4: U3.3 (PE4)
PG9: U3.152 (PG9)
PG10: U3.153 (PG10)
PG11: U3.154 (PG11)
PI8: U3.7 (PI8)
PI11: U3.13 (PI11)
QSPI_BK1_CLK: U3.58 (PB2)
QSPI_BK1_CS: U3.164 (PB6)
QSPI_BK1_IO0: U3.26 (PF8)
QSPI_BK1_IO1: U3.27 (PF9)
QSPI_BK1_IO2: U3.25 (PF7)
QSPI_BK1_IO3: U3.24 (PF6)
RTP-MISO: U3.95 (PB15)
SDIO_CLK: U3.141 (PC12)
SDIO_CMD: U3.144 (PD2)
SDIO_D0: U3.117 (PC8)
SDIO_D1: U3.118 (PC9)
SDIO_D2: U3.139 (PC10)
SDIO_D3: U3.140 (PC11)
SPI1_CS: U3.101 (PD13)
SPI1_MISO: U3.162 (PB4)
SPI1_MOSI: U3.163 (PB5)
SPI1_SCK: U3.161 (PB3)
SWCLK: U3.137 (PA14)
SWDIO: U3.124 (PA13)
USART1_RX: U3.121 (PA10)
USART1_TX: U3.120 (PA9)
USB_D+: U3.123 (PA12)
USB_D-: U3.122 (PA11)
VBAT: D1.1 (A1)
VBAT_MCU: C5.2, D1.3 (K), U3.6 (VBAT)
VCAP1: C45.1, U3.81 (VCAP)
VCAP2: C46.1, U3.125 (VCAP)
VDD: C29.2, C30.2, C31.1, C32.1, C33.1, C34.1, C35.1, C36.1, C37.1, C38.1, C39.1, C40.1, C41.1, C42.1, C43.1, C44.1, D1.2 (A2), FB4.1, FB5.1, R13.1, R15.1, U3.15 (VDD), U3.23 (VDD), U3.36 (VDD), U3.49 (VDD), U3.62 (VDD), U3.72 (VDD), U3.82 (VDD), U3.91 (VDD), U3.103 (VDD), U3.114 (VDD33USB), U3.127 (VDD), U3.136 (VDD), U3.149 (VDD), U3.159 (VDD), U3.172 (VDD)
VDDA: C27.2, C28.2, FB4.2, U3.39 (VDDA)
VREF: FB3.1
VREF+: C21.2, C22.2, FB3.2, U3.38 (VREF+)
WK_UP: SW2.2, U3.40 (PA0)

Notes on the sheet:
MCU - Power / System
MCU - Port A / B
MCU - Port C / D
MCU - Port E / F
MCU - Port G / H / I
CLOCKS
KEY / RESET
PWR_FLAG (ERC)
