DaviVolcan/STM32H743IIT6-Core-Board/hardware/kicad/STM32H743_CoreBoard/memory.kicad_sch

## KiCad design hardware/kicad/STM32H743_CoreBoard/memory.kicad_sch (2026-11-04)

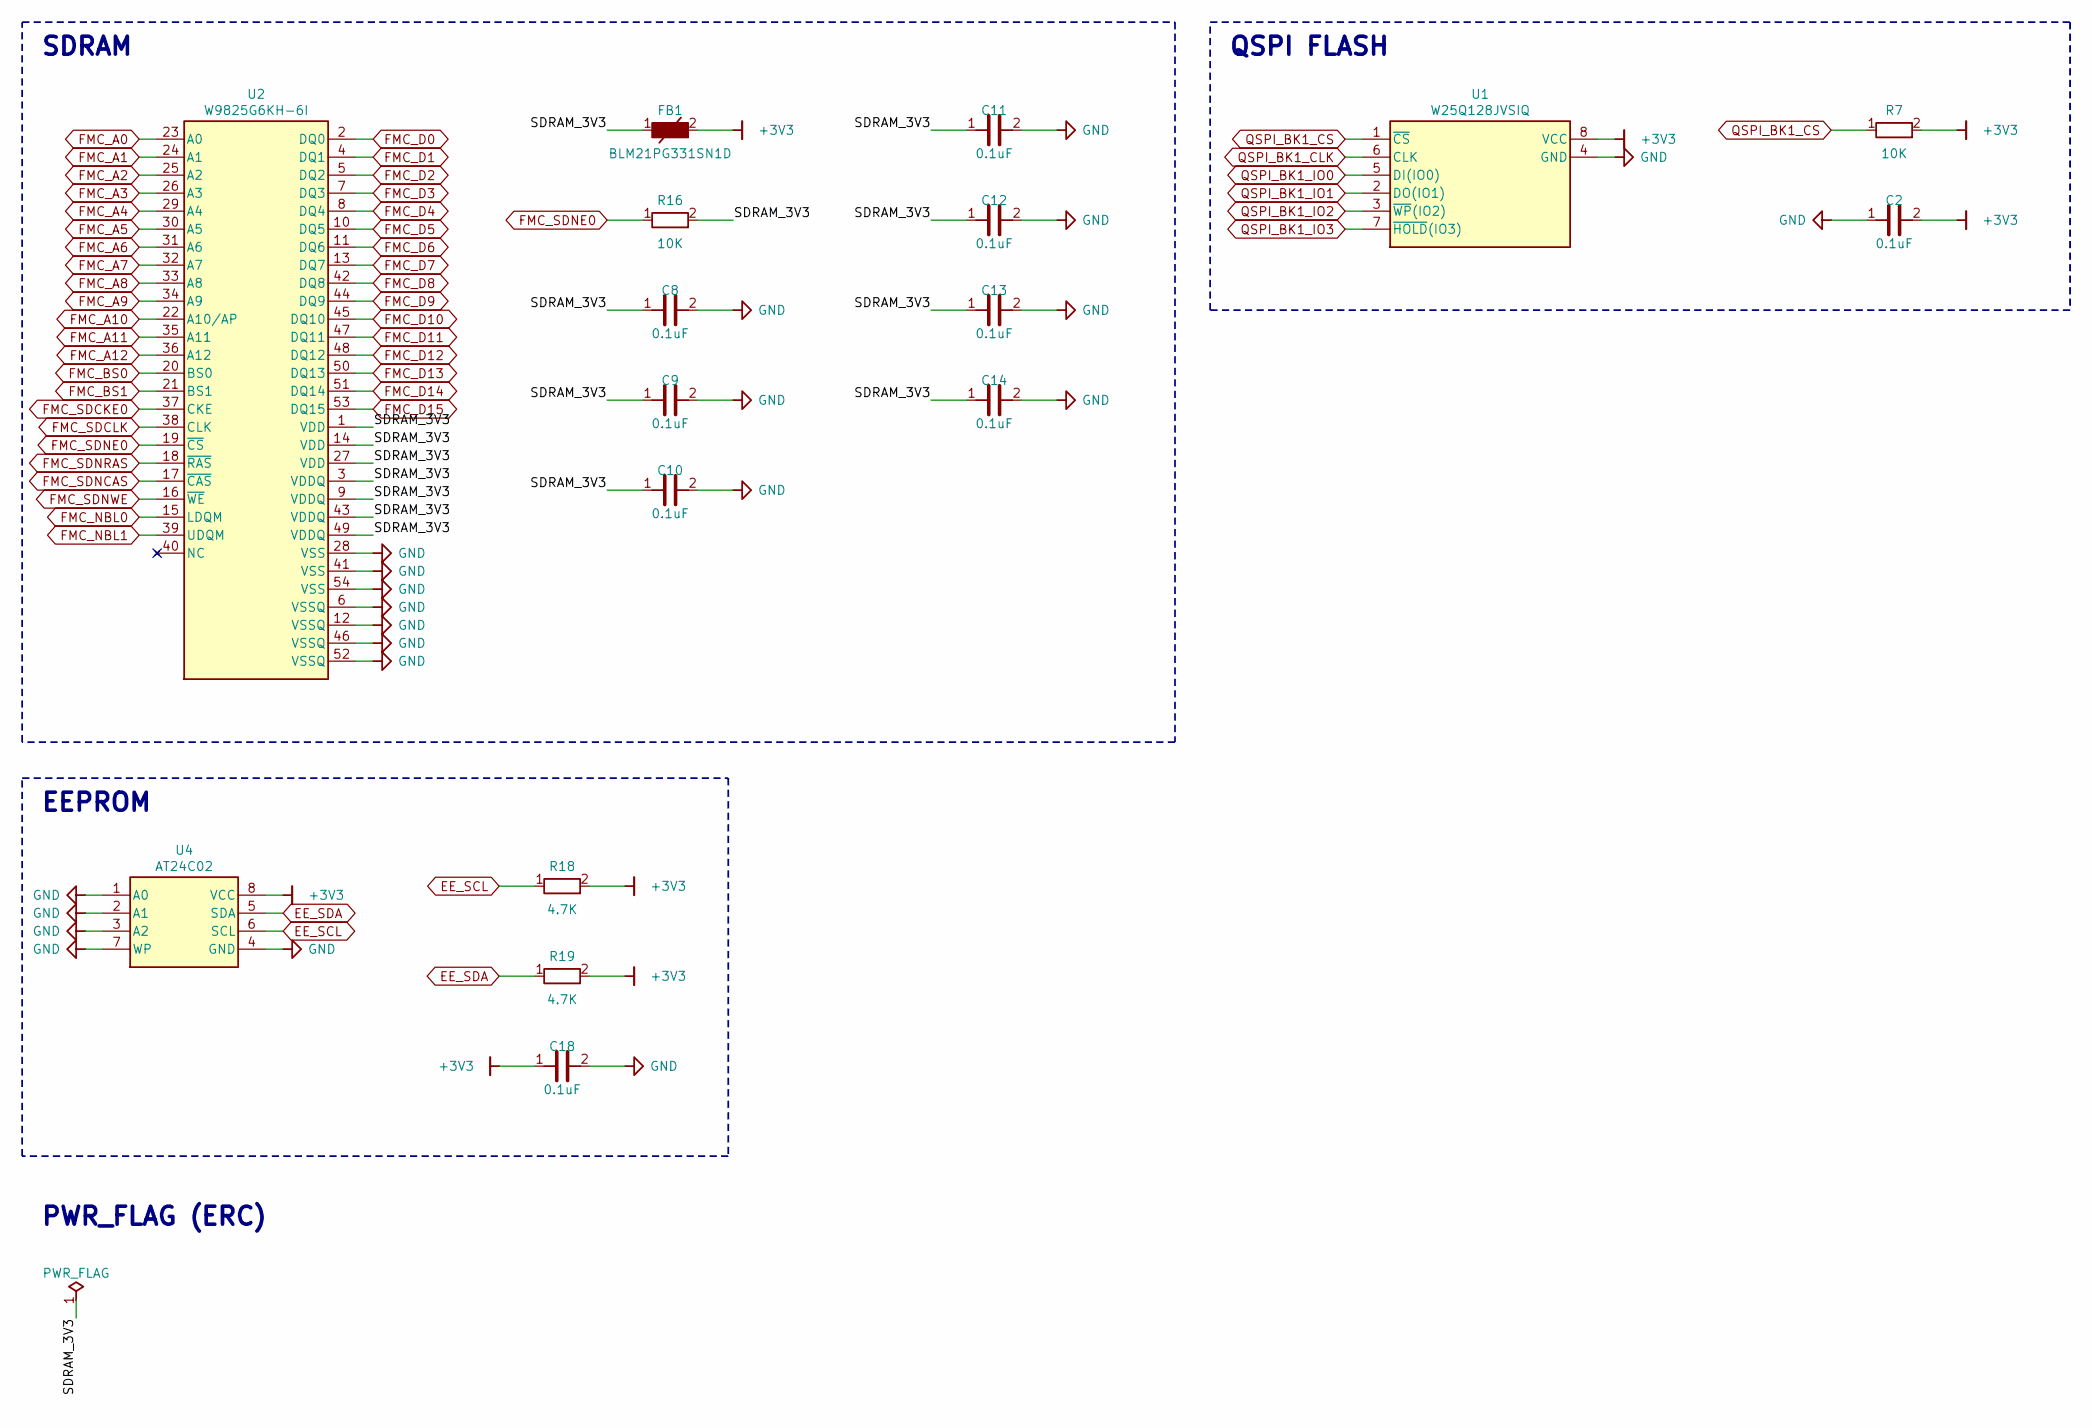
[picture p17: schematic memory.kicad_sch]

Parts:
C2, C8, C9, C10, C11, C12, C13, C14, C18: 0.1uF; C_0603_1608Metric
FB1: BLM21PG331SN1D; L_0805_2012Metric
R7, R16: 10K; R_0603_1608Metric
R18, R19: 4.7K; R_0603_1608Metric
U1: W25Q128JVSIQ; SOIC-8_5.23x5.23mm_P1.27mm
U2: W9825G6KH-6I; TSOP-II-54_22.2x10.16mm_P0.8mm
U4: AT24C02; SOIC-8_3.9x4.9mm_P1.27mm

Connections:
+3V3: C2.2, C18.1, FB1.2, R7.2, R18.2, R19.2, U1.8 (VCC), U4.8 (VCC)
EE_SCL: R18.1, U4.6 (SCL)
EE_SDA: R19.1, U4.5 (SDA)
FMC_A0: U2.23 (A0)
FMC_A1: U2.24 (A1)
FMC_A2: U2.25 (A2)
FMC_A3: U2.26 (A3)
FMC_A4: U2.29 (A4)
FMC_A5: U2.30 (A5)
FMC_A6: U2.31 (A6)
FMC_A7: U2.32 (A7)
FMC_A8: U2.33 (A8)
FMC_A9: U2.34 (A9)
FMC_A10: U2.22 (A10/AP)
FMC_A11: U2.35 (A11)
FMC_A12: U2.36 (A12)
FMC_BS0: U2.20 (BS0)
FMC_BS1: U2.21 (BS1)
FMC_D0: U2.2 (DQ0)
FMC_D1: U2.4 (DQ1)
FMC_D2: U2.5 (DQ2)
FMC_D3: U2.7 (DQ3)
FMC_D4: U2.8 (DQ4)
FMC_D5: U2.10 (DQ5)
FMC_D6: U2.11 (DQ6)
FMC_D7: U2.13 (DQ7)
FMC_D8: U2.42 (DQ8)
FMC_D9: U2.44 (DQ9)
FMC_D10: U2.45 (DQ10)
FMC_D11: U2.47 (DQ11)
FMC_D12: U2.48 (DQ12)
FMC_D13: U2.50 (DQ13)
FMC_D14: U2.51 (DQ14)
FMC_D15: U2.53 (DQ15)
FMC_NBL0: U2.15 (LDQM)
FMC_NBL1: U2.39 (UDQM)
FMC_SDCKE0: U2.37 (CKE)
FMC_SDCLK: U2.38 (CLK)
FMC_SDNCAS: U2.17 (~CAS)
FMC_SDNE0: R16.1, U2.19 (~CS)
FMC_SDNRAS: U2.18 (~RAS)
FMC_SDNWE: U2.16 (~WE)
GND: C2.1, C8.2, C9.2, C10.2, C11.2, C12.2, C13.2, C14.2, C18.2, U1.4 (GND), U2.6 (VSSQ), U2.12 (VSSQ), U2.28 (VSS), U2.41 (VSS), U2.46 (VSSQ), U2.52 (VSSQ), U2.54 (VSS), U4.1 (A0), U4.2 (A1), U4.3 (A2), U4.4 (GND), U4.7 (WP)
QSPI_BK1_CLK: U1.6 (CLK)
QSPI_BK1_CS: R7.1, U1.1 (~CS)
QSPI_BK1_IO0: U1.5 (DI(IO0))
QSPI_BK1_IO1: U1.2 (DO(IO1))
QSPI_BK1_IO2: U1.3 (~WP(IO2))
QSPI_BK1_IO3: U1.7 (~HOLD(IO3))
SDRAM_3V3: C8.1, C9.1, C10.1, C11.1, C12.1, C13.1, C14.1, FB1.1, R16.2, U2.1 (VDD), U2.3 (VDDQ), U2.9 (VDDQ), U2.14 (VDD), U2.27 (VDD), U2.43 (VDDQ), U2.49 (VDDQ)

Notes on the sheet:
SDRAM
QSPI FLASH
EEPROM
PWR_FLAG (ERC)
