DaviVolcan/STM32H743IIT6-Core-Board/hardware/kicad/STM32H743_CoreBoard/power_usb.kicad_sch

## KiCad design hardware/kicad/STM32H743_CoreBoard/power_usb.kicad_sch (2026-11-04)

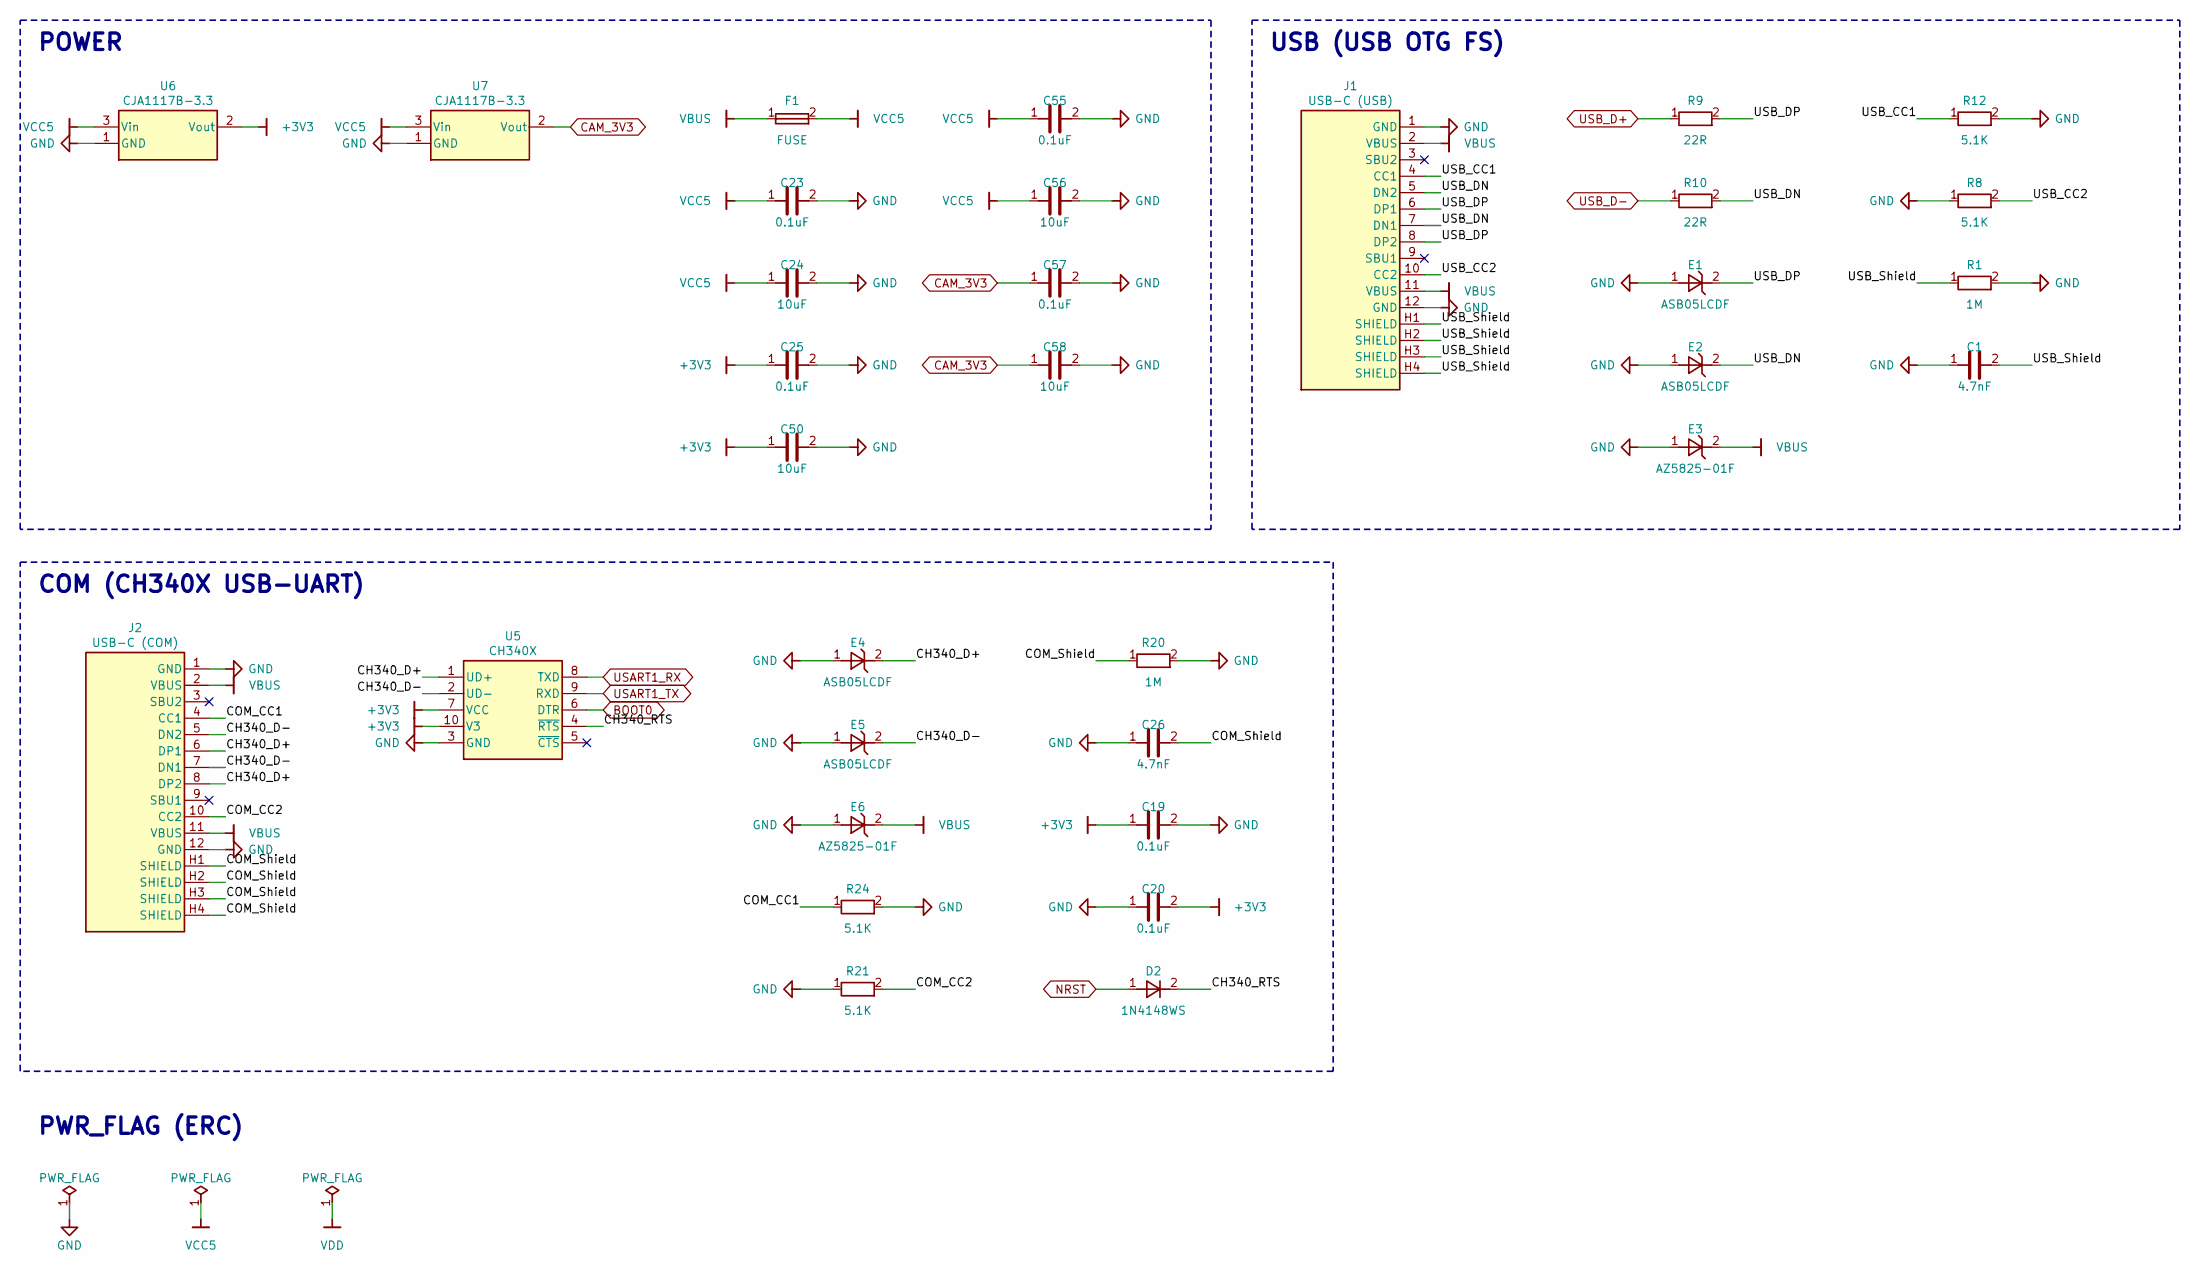
[picture p18: schematic power_usb.kicad_sch]

Parts:
C1, C26: 4.7nF; C_0603_1608Metric
C19, C20, C23, C25, C55, C57: 0.1uF; C_0603_1608Metric
C24, C50, C56, C58: 10uF; C_0805_2012Metric
D2: 1N4148WS; D_SOD-323
E1, E2, E4, E5: ASB05LCDF; D_SOD-523
E3, E6: AZ5825-01F; D_SOD-323
F1: FUSE; Fuse_1206_3216Metric
J1: USB-C (USB)
J2: USB-C (COM)
R1, R20: 1M; R_0603_1608Metric
R8, R12, R21, R24: 5.1K; R_0603_1608Metric
R9, R10: 22R; R_0603_1608Metric
U5: CH340X; MSOP-10_3x3mm_P0.5mm
U6, U7: CJA1117B-3.3; SOT-223-3_TabPin2

Connections:
+3V3: C19.1, C20.2, C25.1, C50.1, U5.7 (VCC), U5.10 (V3), U6.2 (Vout)
BOOT0: U5.6 (DTR)
CAM_3V3: C57.1, C58.1, U7.2 (Vout)
CH340_D+: E4.2, J2.6 (DP1), J2.8 (DP2), U5.1 (UD+)
CH340_D-: E5.2, J2.5 (DN2), J2.7 (DN1), U5.2 (UD-)
CH340_RTS: D2.2, U5.4 (~RTS)
COM_CC1: J2.4 (CC1), R24.1
COM_CC2: J2.10 (CC2), R21.2
COM_Shield: C26.2, J2.H1 (SHIELD), J2.H2 (SHIELD), J2.H3 (SHIELD), J2.H4 (SHIELD), R20.1
GND: C1.1, C19.2, C20.1, C23.2, C24.2, C25.2, C26.1, C50.2, C55.2, C56.2, C57.2, C58.2, E1.1, E2.1, E3.1, E4.1, E5.1, E6.1, J1.1 (GND), J1.12 (GND), J2.1 (GND), J2.12 (GND), R1.2, R8.1, R12.2, R20.2, R21.1, R24.2, U5.3 (GND), U6.1 (GND), U7.1 (GND)
NRST: D2.1
USART1_RX: U5.8 (TXD)
USART1_TX: U5.9 (RXD)
USB_CC1: J1.4 (CC1), R12.1
USB_CC2: J1.10 (CC2), R8.2
USB_D+: R9.1
USB_D-: R10.1
USB_DN: E2.2, J1.5 (DN2), J1.7 (DN1), R10.2
USB_DP: E1.2, J1.6 (DP1), J1.8 (DP2), R9.2
USB_Shield: C1.2, J1.H1 (SHIELD), J1.H2 (SHIELD), J1.H3 (SHIELD), J1.H4 (SHIELD), R1.1
VBUS: E3.2, E6.2, F1.1, J1.2 (VBUS), J1.11 (VBUS), J2.2 (VBUS), J2.11 (VBUS)
VCC5: C23.1, C24.1, C55.1, C56.1, F1.2, U6.3 (Vin), U7.3 (Vin)

Notes on the sheet:
POWER
USB (USB OTG FS)
COM (CH340X USB-UART)
PWR_FLAG (ERC)
