DaviVolcan/STM32H743IIT6-Core-Board/(commit log)

2026-04-10 add documentation for STM32H743IIT6 Core Board V1.3 peripherals and pin assignments
2026-04-10 add .gitignore to exclude IDE files and schematic documents
2026-04-10 add board pictures for STM32H743IIT6 Core Board with notes on modifications
2026-04-10 add pinout details for DCMI camera interface including connector pin mapping
2026-04-10 update README.md to correct external QSPI Flash size and remove on-board peripherals section
2026-04-14 update pinout.md to correct FMC pin assignments for better accuracy
2026-11-04 add EEPROM close-up photo and identify part as AT24C02C
    The marking ATMLH518 / 02CM decodes to an Atmel (Microchip) AT24C02C
    made in week 18 of 2025. Document its size, page size, write time and
    address, and correct the bus to I2C2, since PH4/PH5 are I2C2 pins.
2026-11-04 add component close-up photos and identify on-board parts
    Close-ups of the top side show the part markings of the main
    components. Document them in peripherals.md:
    - HSE: 25 MHz YXC crystal (Y2); LSE: 32.768 kHz crystal (Y1)
    - QSPI flash: Winbond W25Q128JV (U1)
    - SDRAM: Winbond W9825G6KH-6I (U2), with organization and refresh
    - USB-UART bridge: WCH CH340X (U5), not CH340G
    - 3.3 V LDO: 1117-type (U7); resettable fuse F1 on the USB input
2026-11-04 fix KEY0 pin in pinout.md
    KEY0 is wired to PA1 and is active high, as confirmed on the board and
    as already stated in peripherals.md. The table listed PE4, active low.
2026-11-04 move KEY0 header warning from PE4 to PA1
    KEY0 is on PA1 (header P1 pin 12), not on PE4.
2026-11-04 link component close-up photos from README
    List the close-up photos in assets/ under Board Pictures and link each
    one to the peripherals.md sections it documents.
2026-11-04 add KiCad re-capture of the V1.3 schematic
    Add a community re-capture of the board schematic in KiCad, split into
    MCU, Memory, Power_USB, IO and Display_Camera sheets, with its symbol
    library and a PDF render.
    Allow hardware/kicad/ in .gitignore while keeping the original
    manufacturer schematic ignored, and update the README note: the
    original is not included because the manufacturer could not be
    contacted.
